P-Shreyas543/BatteryPack_16S_A4_Breakout/board_top_render.png

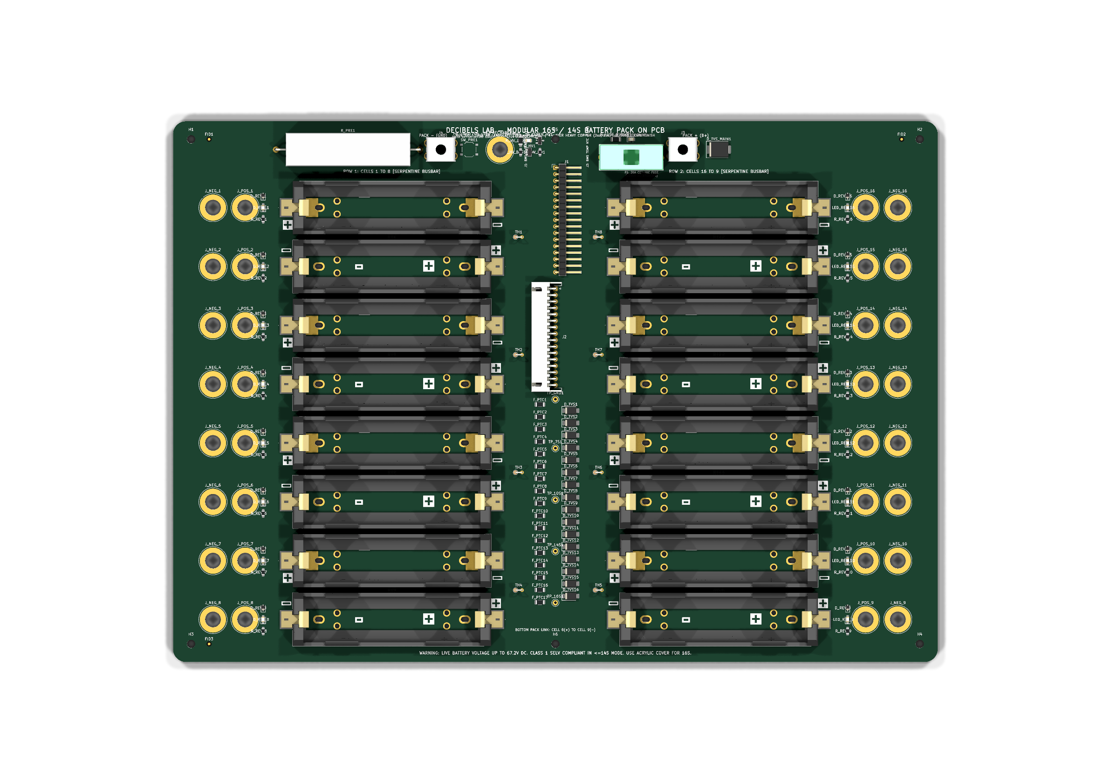
board_top_render.png
