P-Shreyas543/BatteryPack_16S_A4_Breakout/step_scatter.png

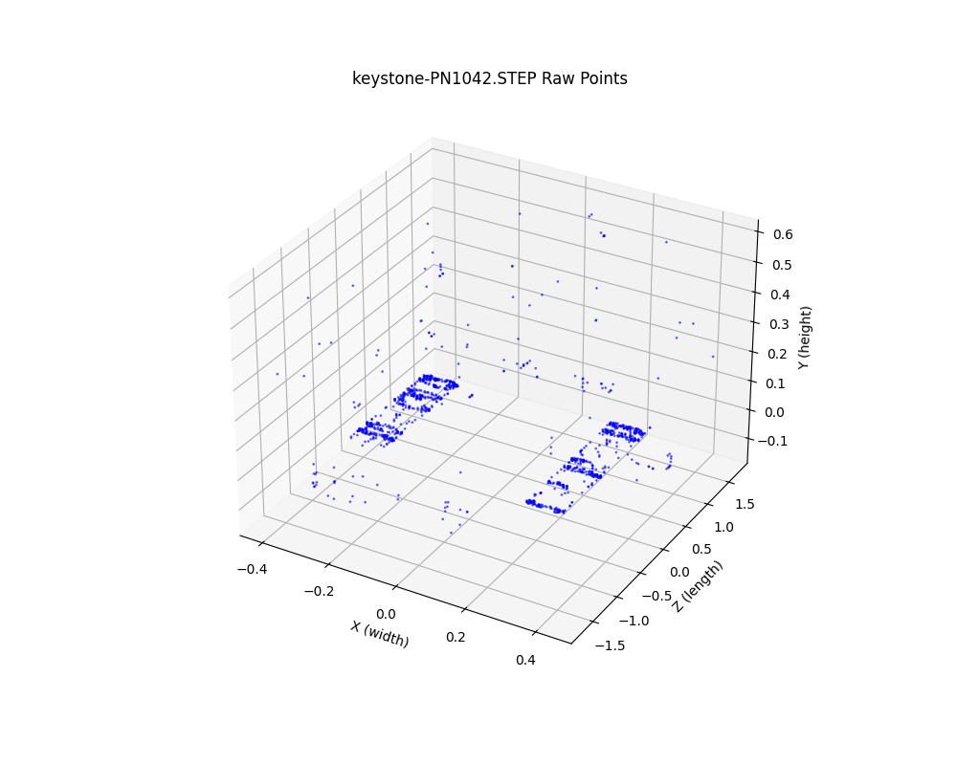
step_scatter.png
