P-Shreyas543/BatteryPack_16S_A4_Breakout/test_all_keystone.png

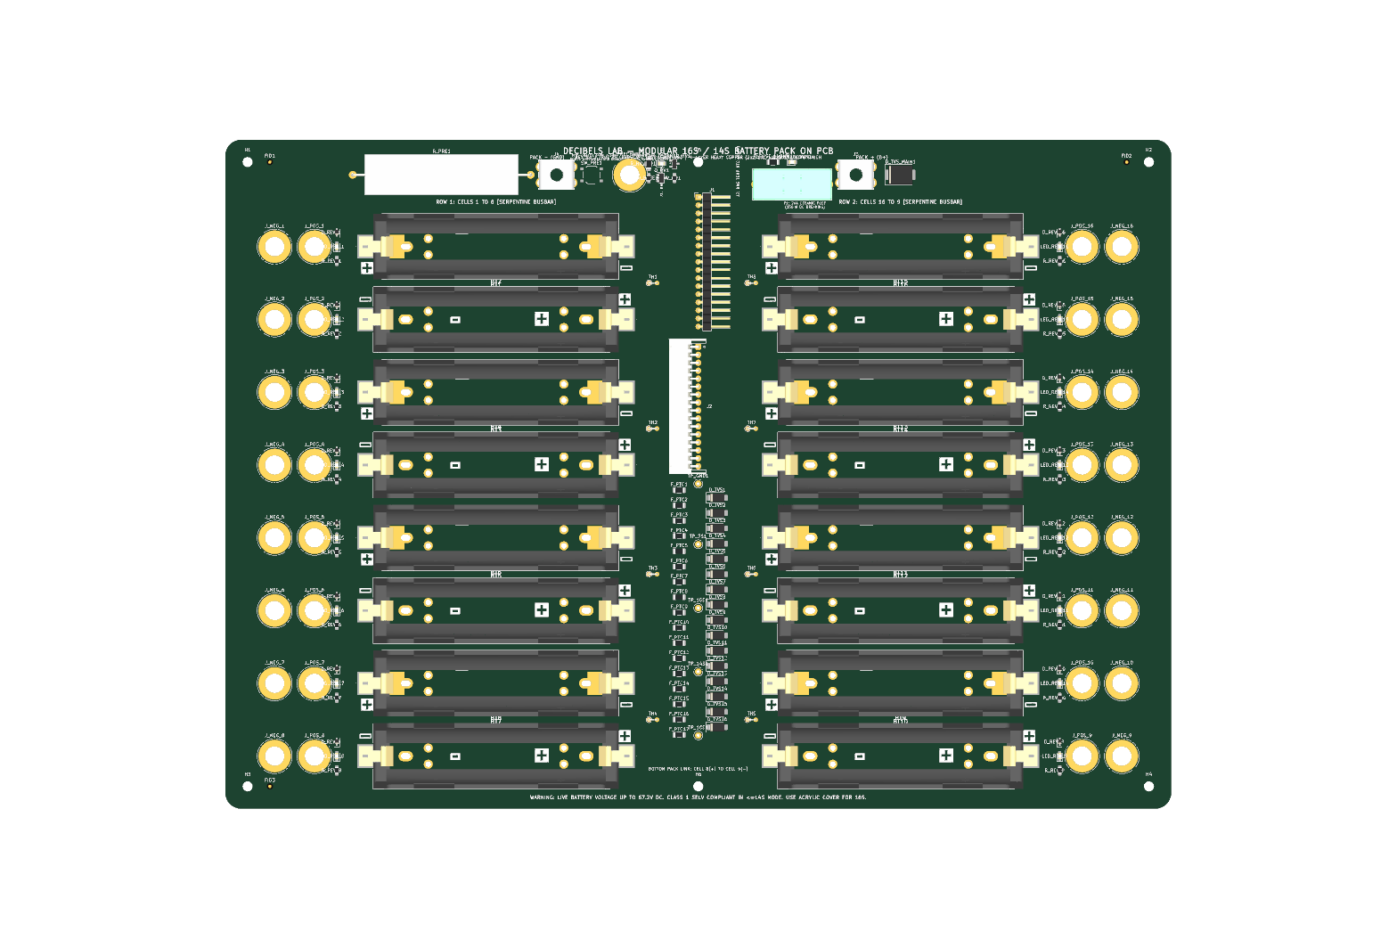
test_all_keystone.png
