P-Shreyas543/BatteryPack_16S_A4_Breakout/test_bt1_render_full.png

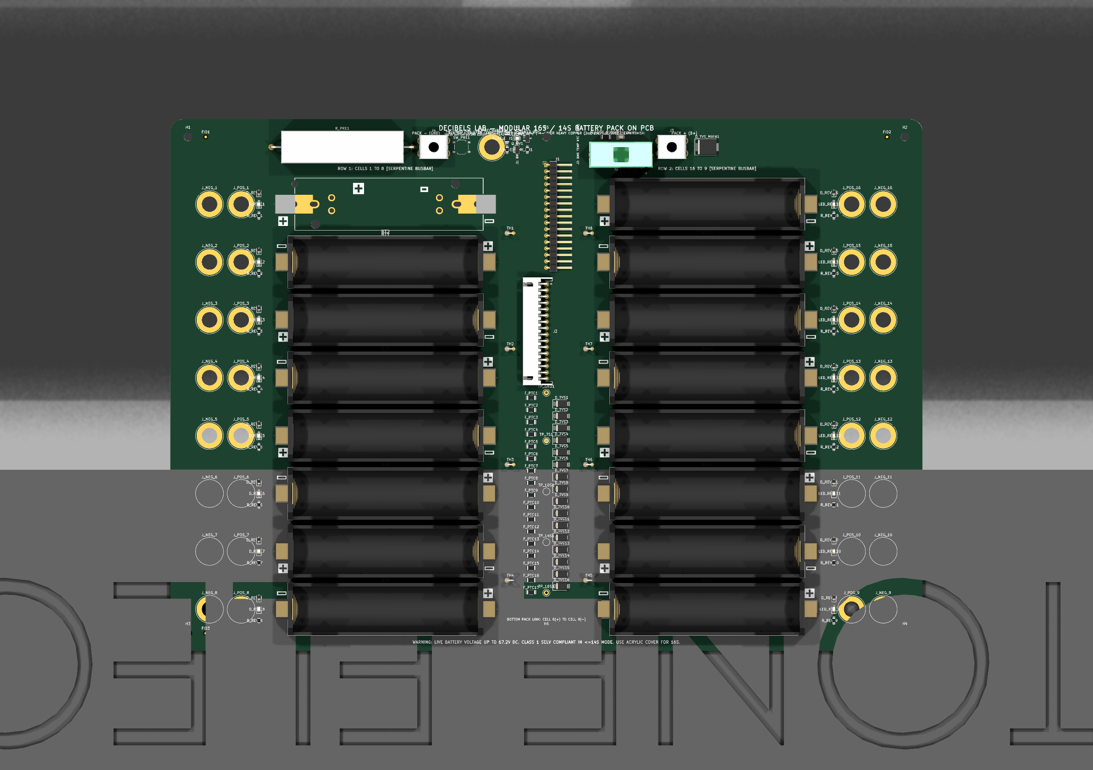
test_bt1_render_full.png
