P-Shreyas543/BatteryPack_16S_A4_Breakout/test_render_bt1.png

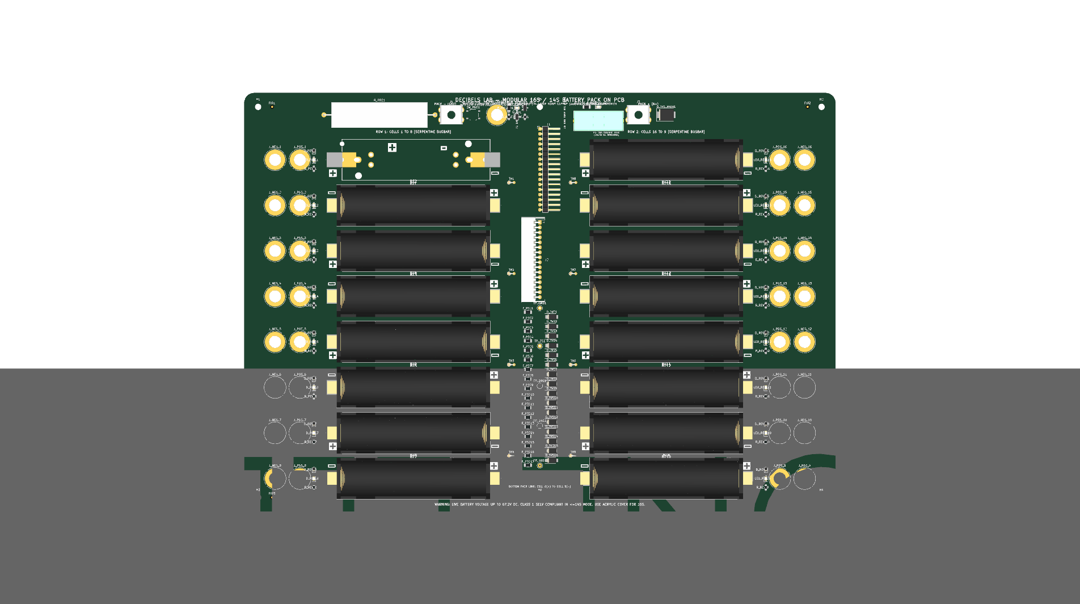
test_render_bt1.png
