P-Shreyas543/BatteryPack_16S_A4_Breakout/docs/BatteryPack_14S_Schematic.pdf

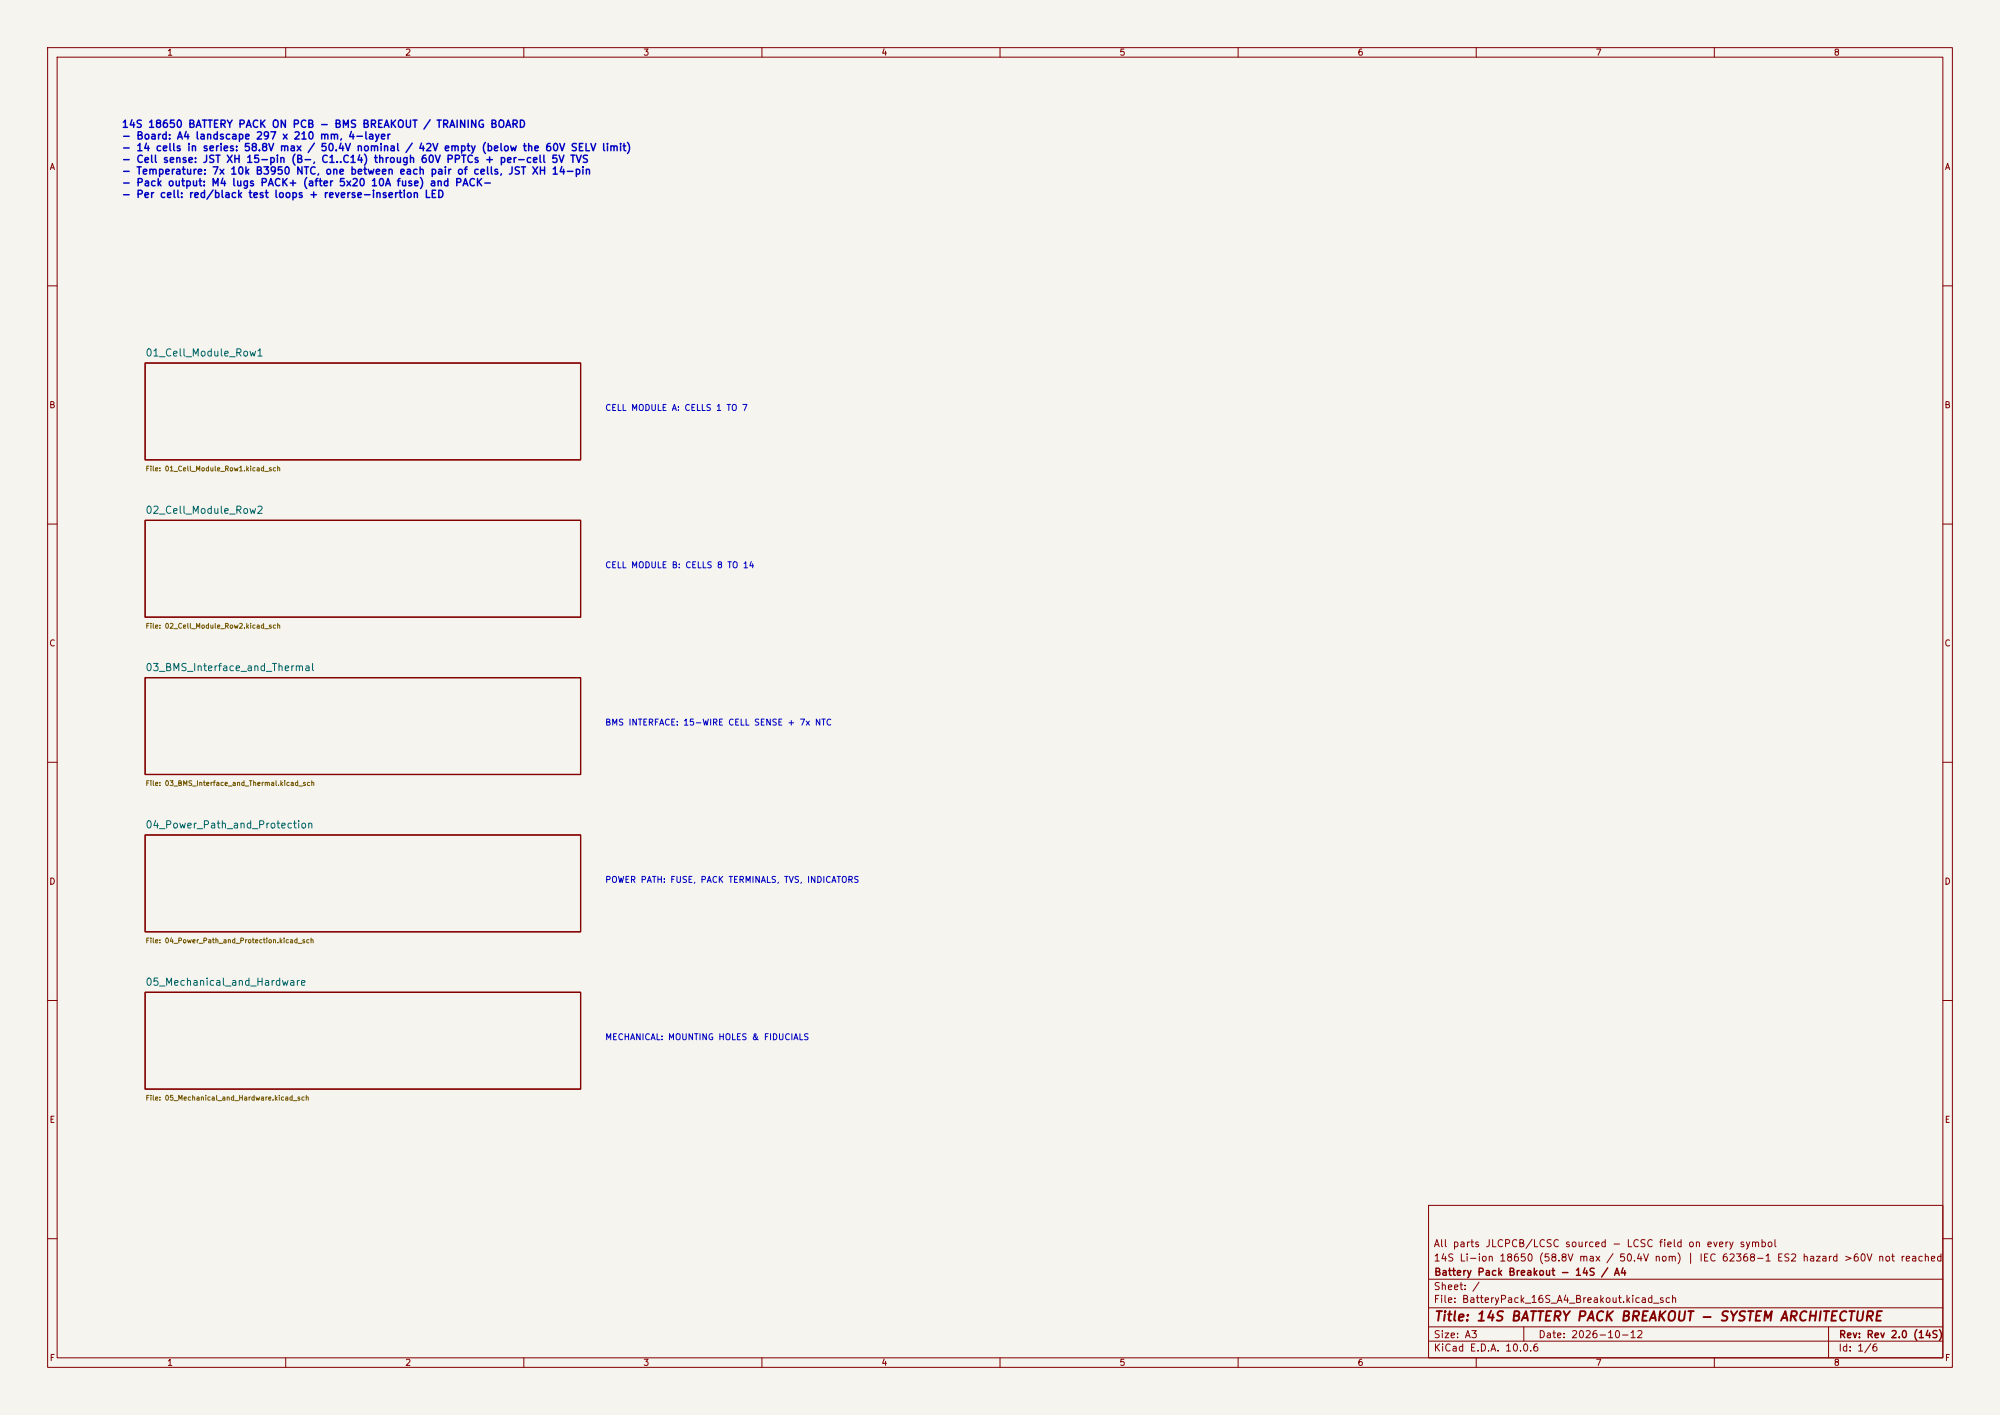
[picture p14: page 1]

14S 18650 BATTERY PACK ON PCB - BMS BREAKOUT / TRAINING BOARD - Board: A4 landscape 297 x 210 mm, 4-layer - 14 cells in series: 58.8V max / 50.4V nominal / 42V empty (below the 60V SELV limit) - Cell sense: JST XH 15-pin (B-, C1..C14) through 60V PPTCs + per-cell 5V TVS - Temperature: 7x 10k B3950 NTC, one between each pair of cells, JST XH 14-pin - Pack output: M4 lugs PACK+ (after 5x20 10A fuse) and PACK-

- Per cell: red/black test loops + reverse-insertion LED

CELL MODULE A: CELLS 1 TO 7 CELL MODULE B: CELLS 8 TO 14 BMS INTERFACE: 15-WIRE CELL SENSE + 7x NTC

POWER PATH: FUSE, PACK TERMINALS, TVS, INDICATORS MECHANICAL: MOUNTING HOLES & FIDUCIALS

All parts JLCPCB/LCSC sourced - LCSC field on every symbol
14S Li-ion 18650 (58.8V max / 50.4V nom) | IEC 62368-1 ES2 hazard >60V not reached
Battery Pack Breakout - 14S / A4
Sheet: /
File: BatteryPack_16S_A4_Breakout.kicad_sch
Title: 14S BATTERY PACK BREAKOUT - SYSTEM ARCHITECTURE

Size: A3 | Rev: Rev 2.0 (14S) | F Date: 2026-10-12
KiCad E.D.A. 10.0.6 | Id: 1/6

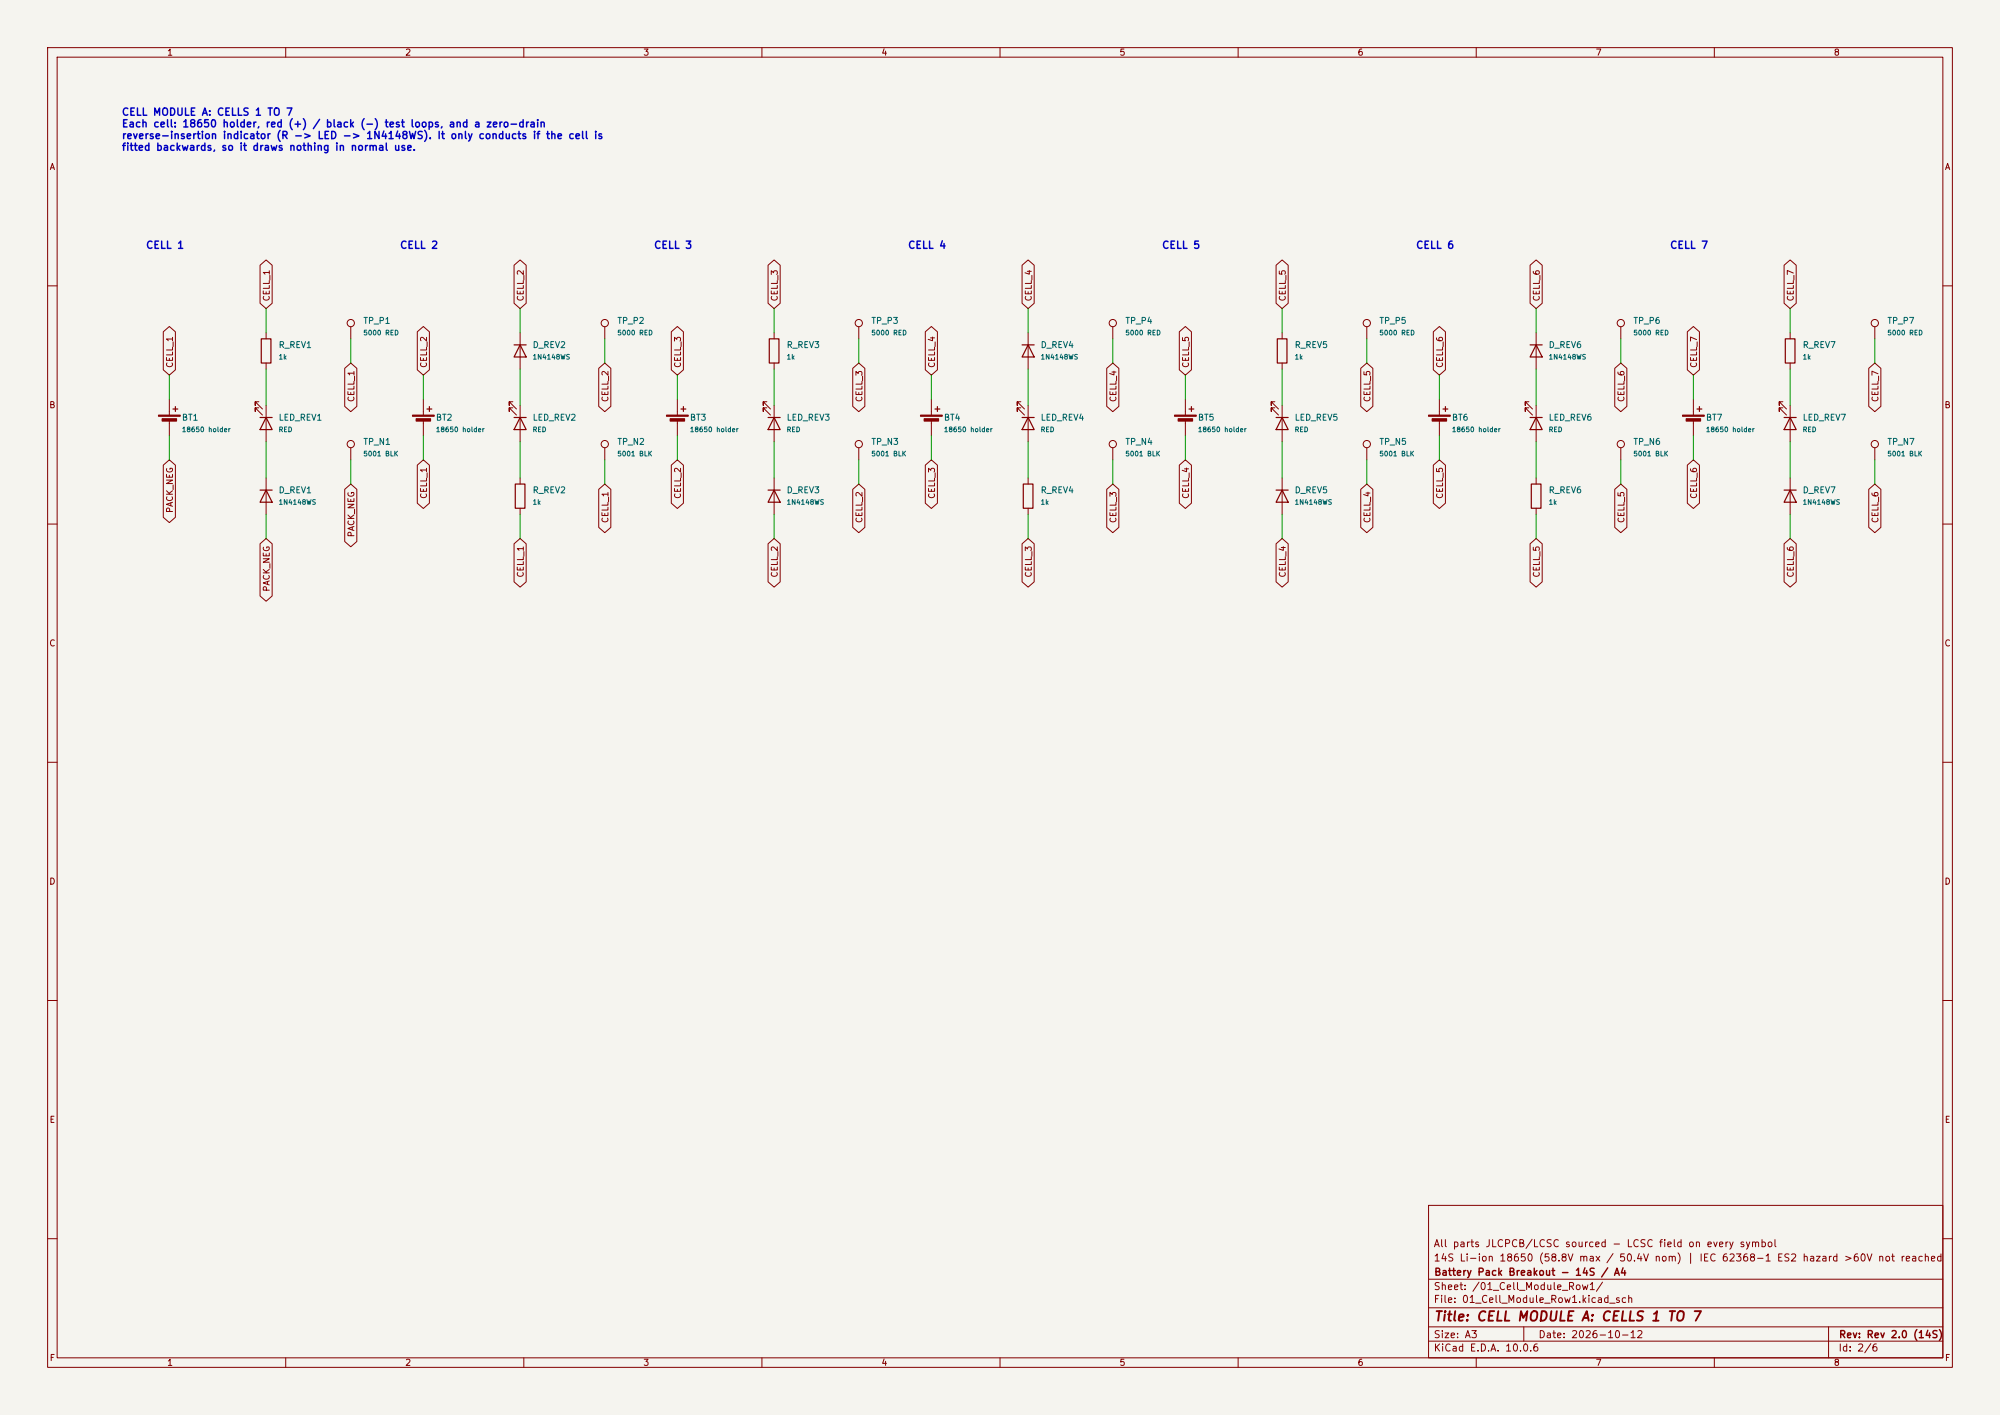
[picture p15: page 2]

CELL MODULE A: CELLS 1 TO 7
Each cell: 18650 holder, red (+) / black (-) test loops, and a zero-drain
reverse-insertion indicator (R -> LED -> 1N4148WS). It only conducts if the cell is

All parts JLCPCB/LCSC sourced - LCSC field on every symbol
14S Li-ion 18650 (58.8V max / 50.4V nom) | IEC 62368-1 ES2 hazard >60V not reached
Battery Pack Breakout - 14S / A4
Sheet: /01_Cell_Module_Row1/
File: 01_Cell_Module_Row1.kicad_sch
Title: CELL MODULE A: CELLS 1 TO 7

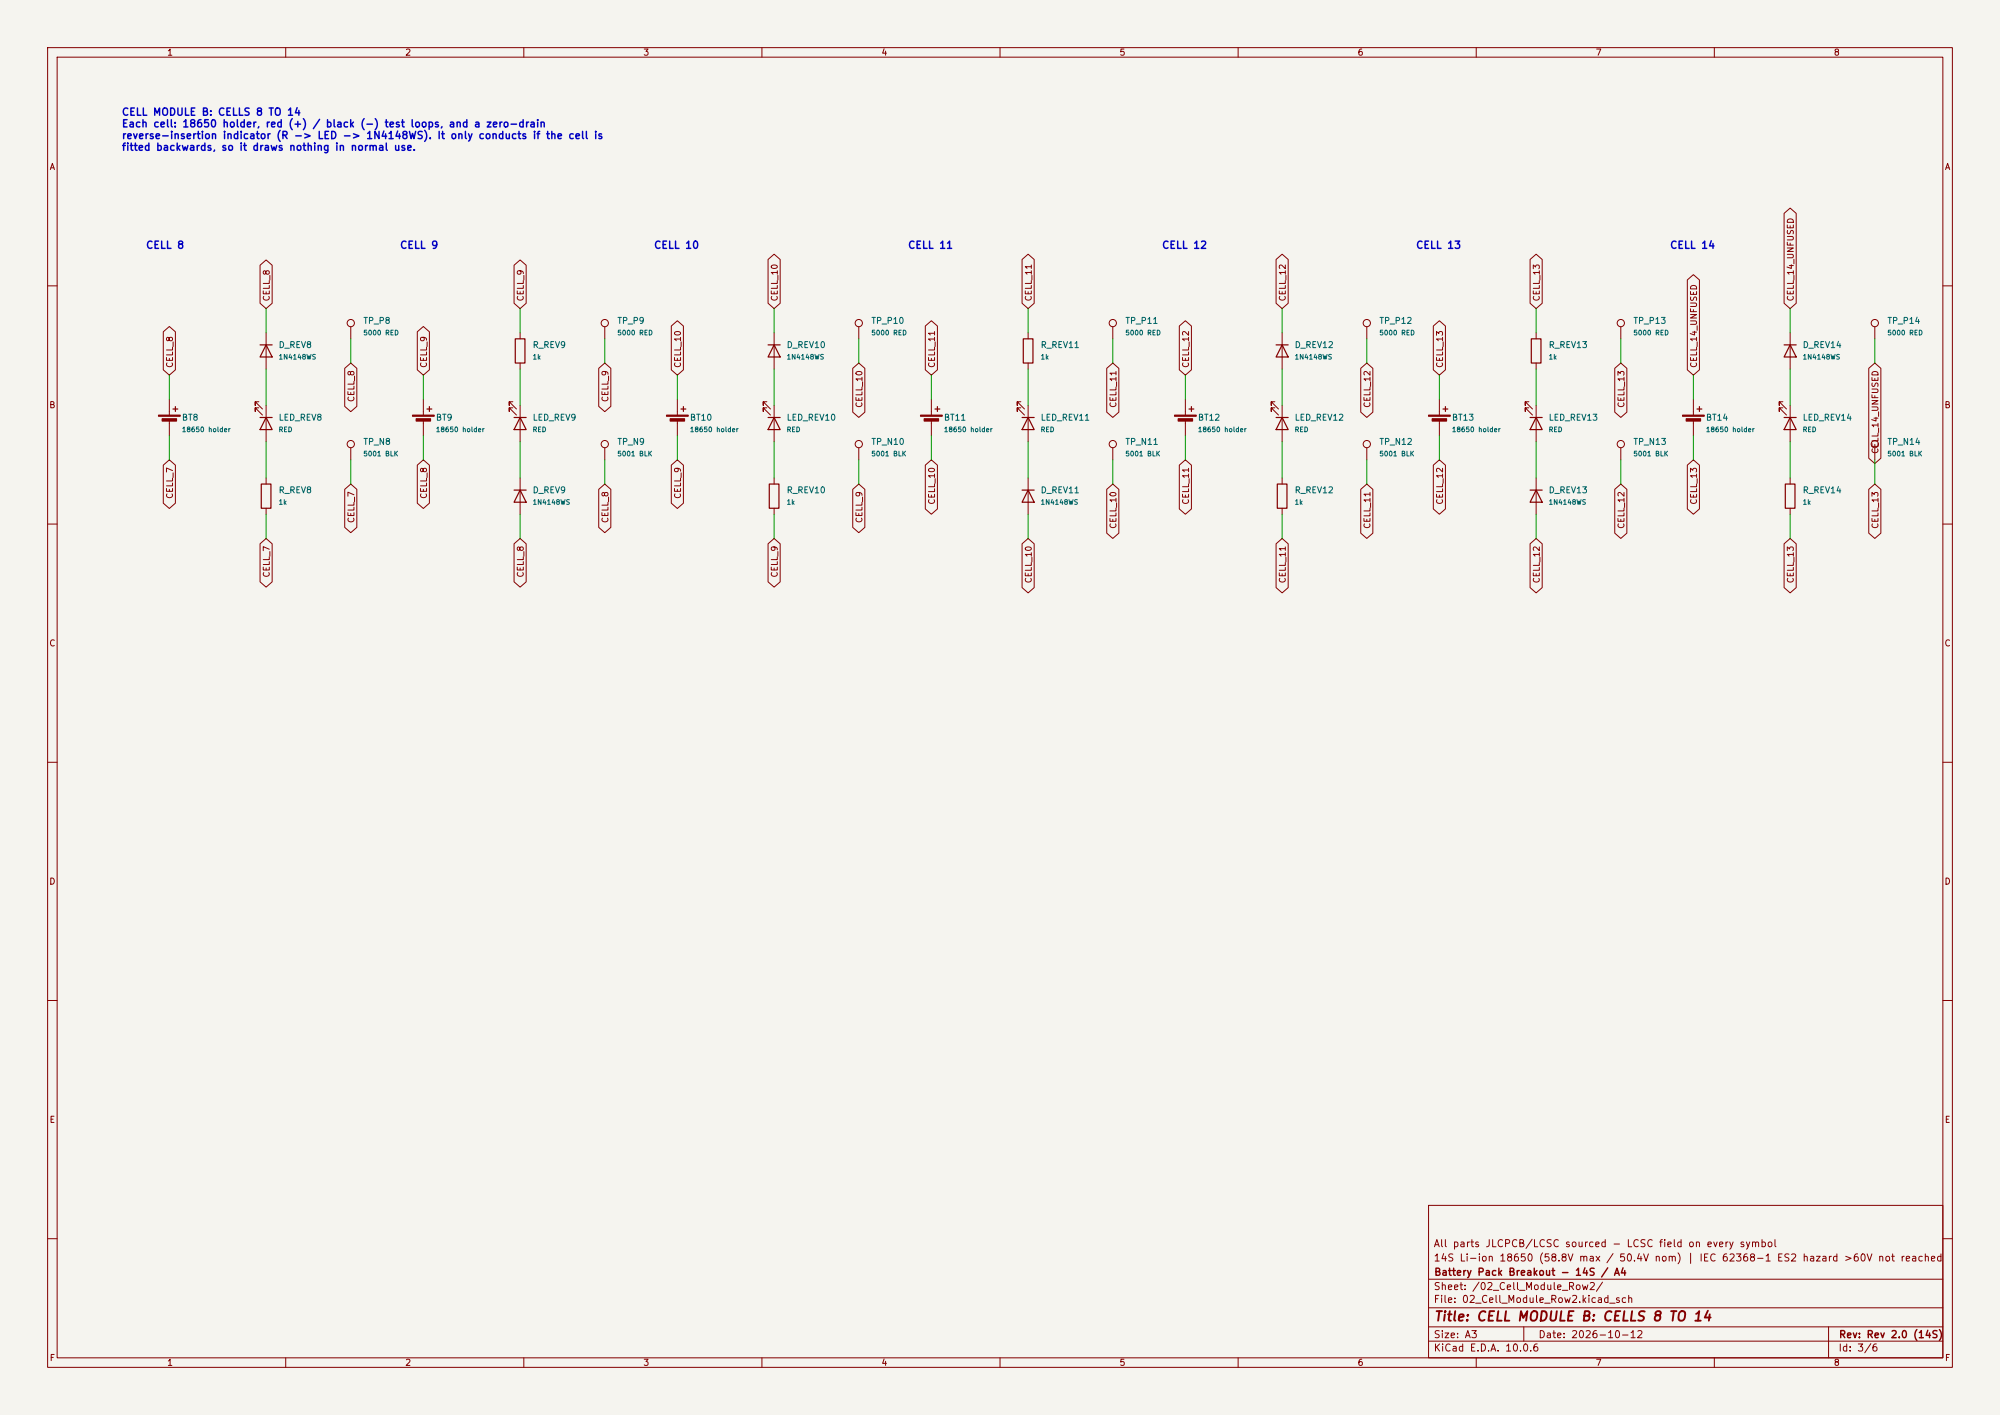
[picture p16: page 3]

CELL MODULE B: CELLS 8 TO 14
Each cell: 18650 holder, red (+) / black (-) test loops, and a zero-drain
reverse-insertion indicator (R -> LED -> 1N4148WS). It only conducts if the cell is
fitted backwards, so it draws nothing in normal use.

All parts JLCPCB/LCSC sourced - LCSC field on every symbol
14S Li-ion 18650 (58.8V max / 50.4V nom) | IEC 62368-1 ES2 hazard >60V not reached
Battery Pack Breakout - 14S / A4
Sheet: /02_Cell_Module_Row2/
File: 02_Cell_Module_Row2.kicad_sch
Title: CELL MODULE B: CELLS 8 TO 14

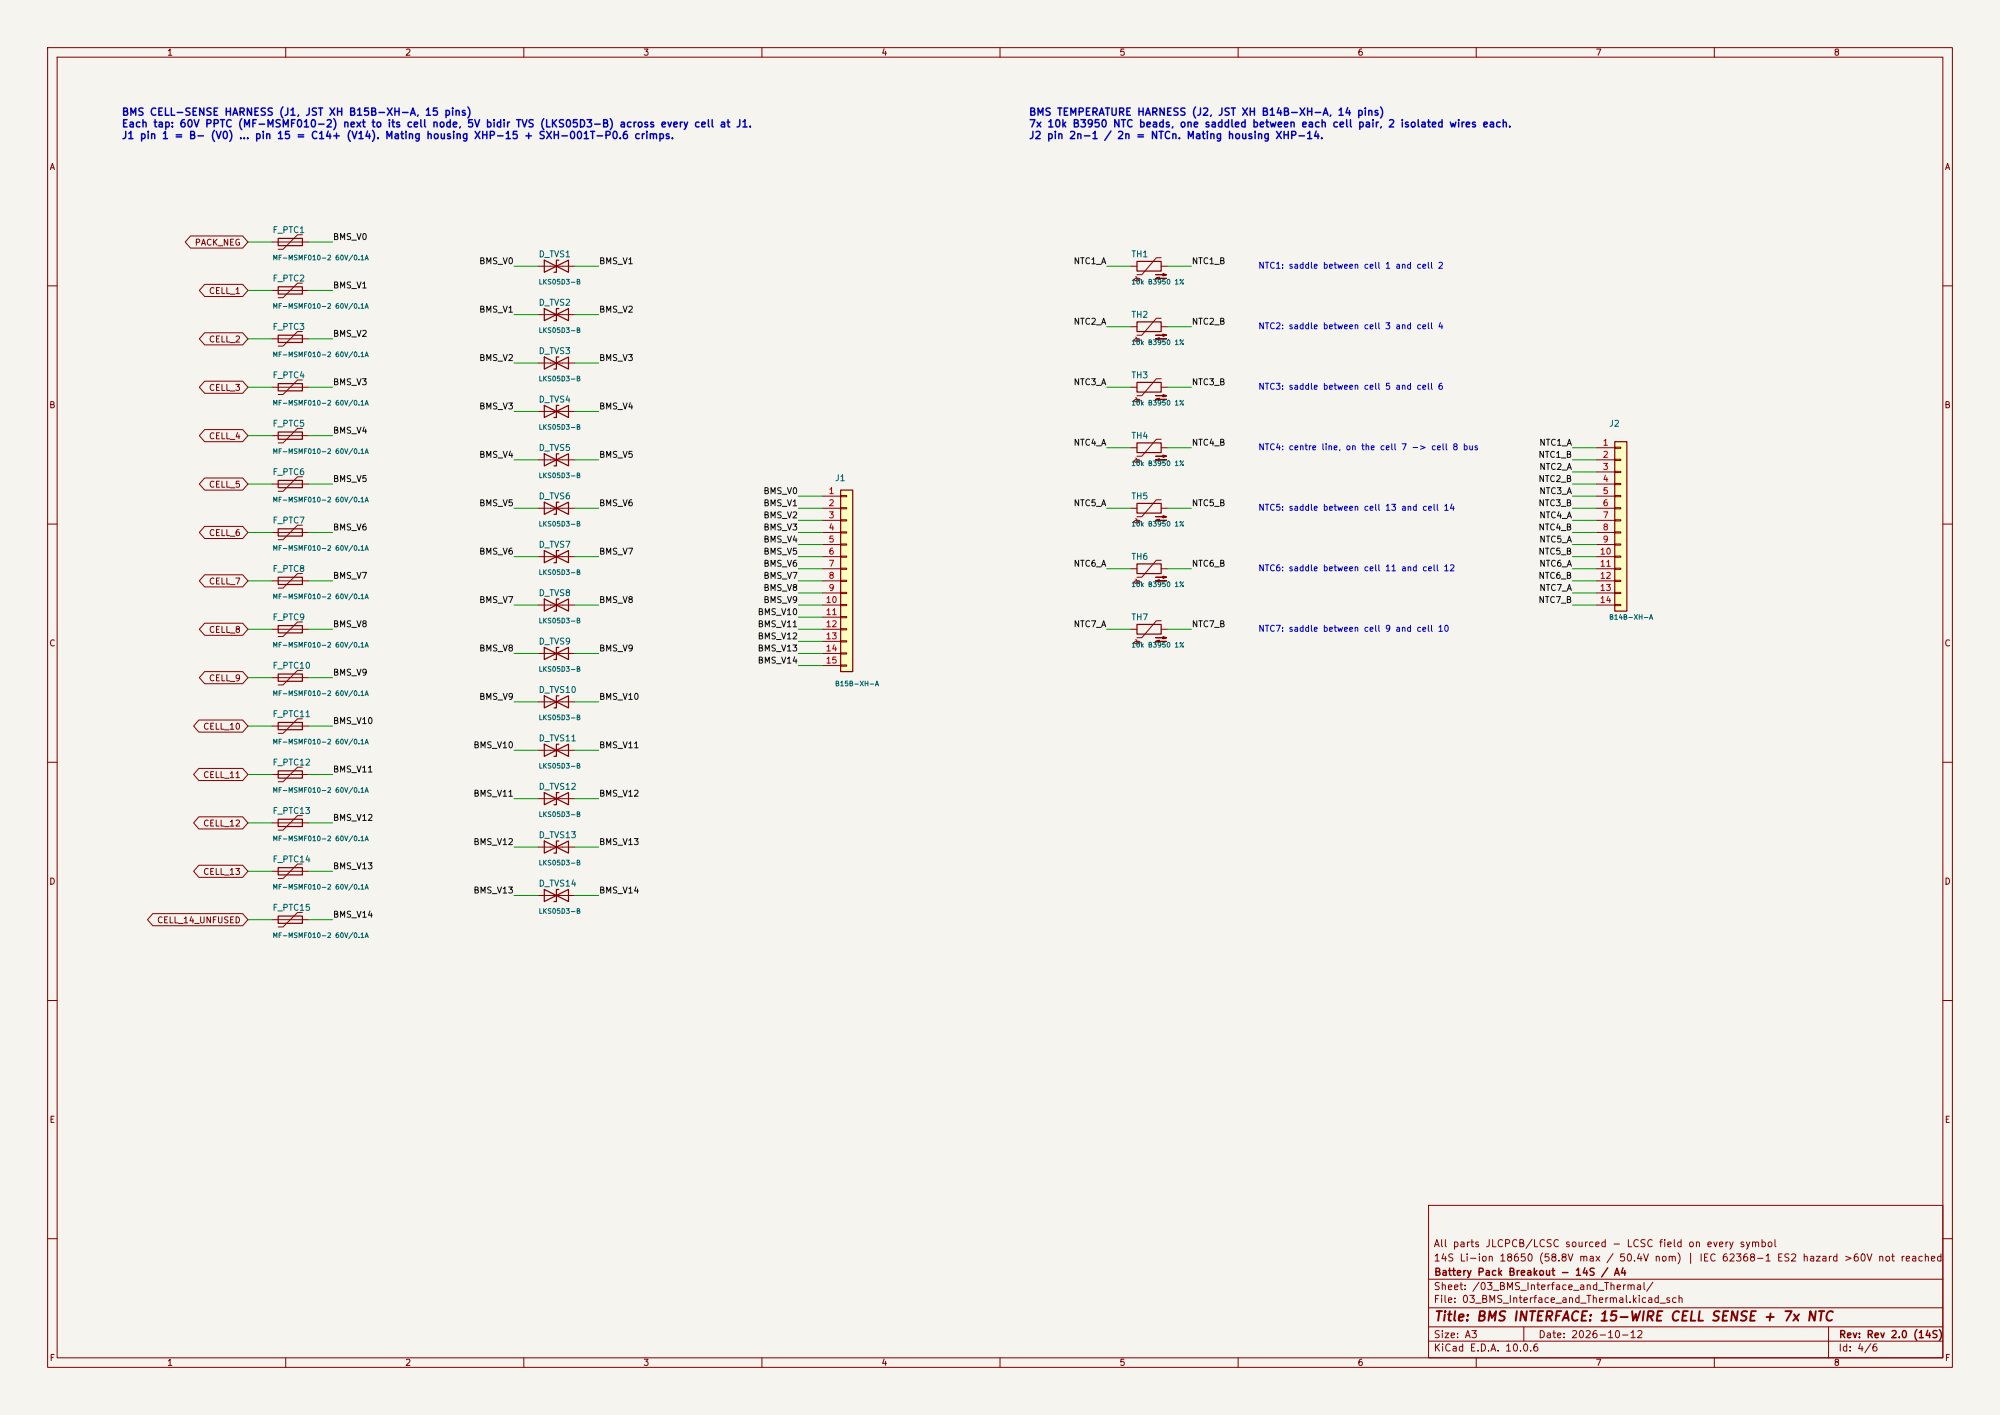
[picture p17: page 4]

J2 pin 2n-1 / 2n = NTCn. Mating housing XHP-14. NTC7: saddle between cell 9 and cell 10 NTC6: saddle between cell 11 and cell 12 BMS CELL-SENSE HARNESS (J1, JST XH B15B-XH-A, 15 pins)
Each tap: 60V PPTC (MF-MSMF010-2) next to its cell node, 5V bidir TVS (LKS05D3-B) across every cell at J1.
CELL_1 CELL_14_UNFUSED

7x 10k B3950 NTC beads, one saddled between each cell pair, 2 isolated wires each.

All parts JLCPCB/LCSC sourced - LCSC field on every symbol
14S Li-ion 18650 (58.8V max / 50.4V nom) | IEC 62368-1 ES2 hazard >60V not reached
Battery Pack Breakout - 14S / A4
Sheet: /03_BMS_Interface_and_Thermal/
File: 03_BMS_Interface_and_Thermal.kicad_sch
Title: BMS INTERFACE: 15-WIRE CELL SENSE + 7x NTC

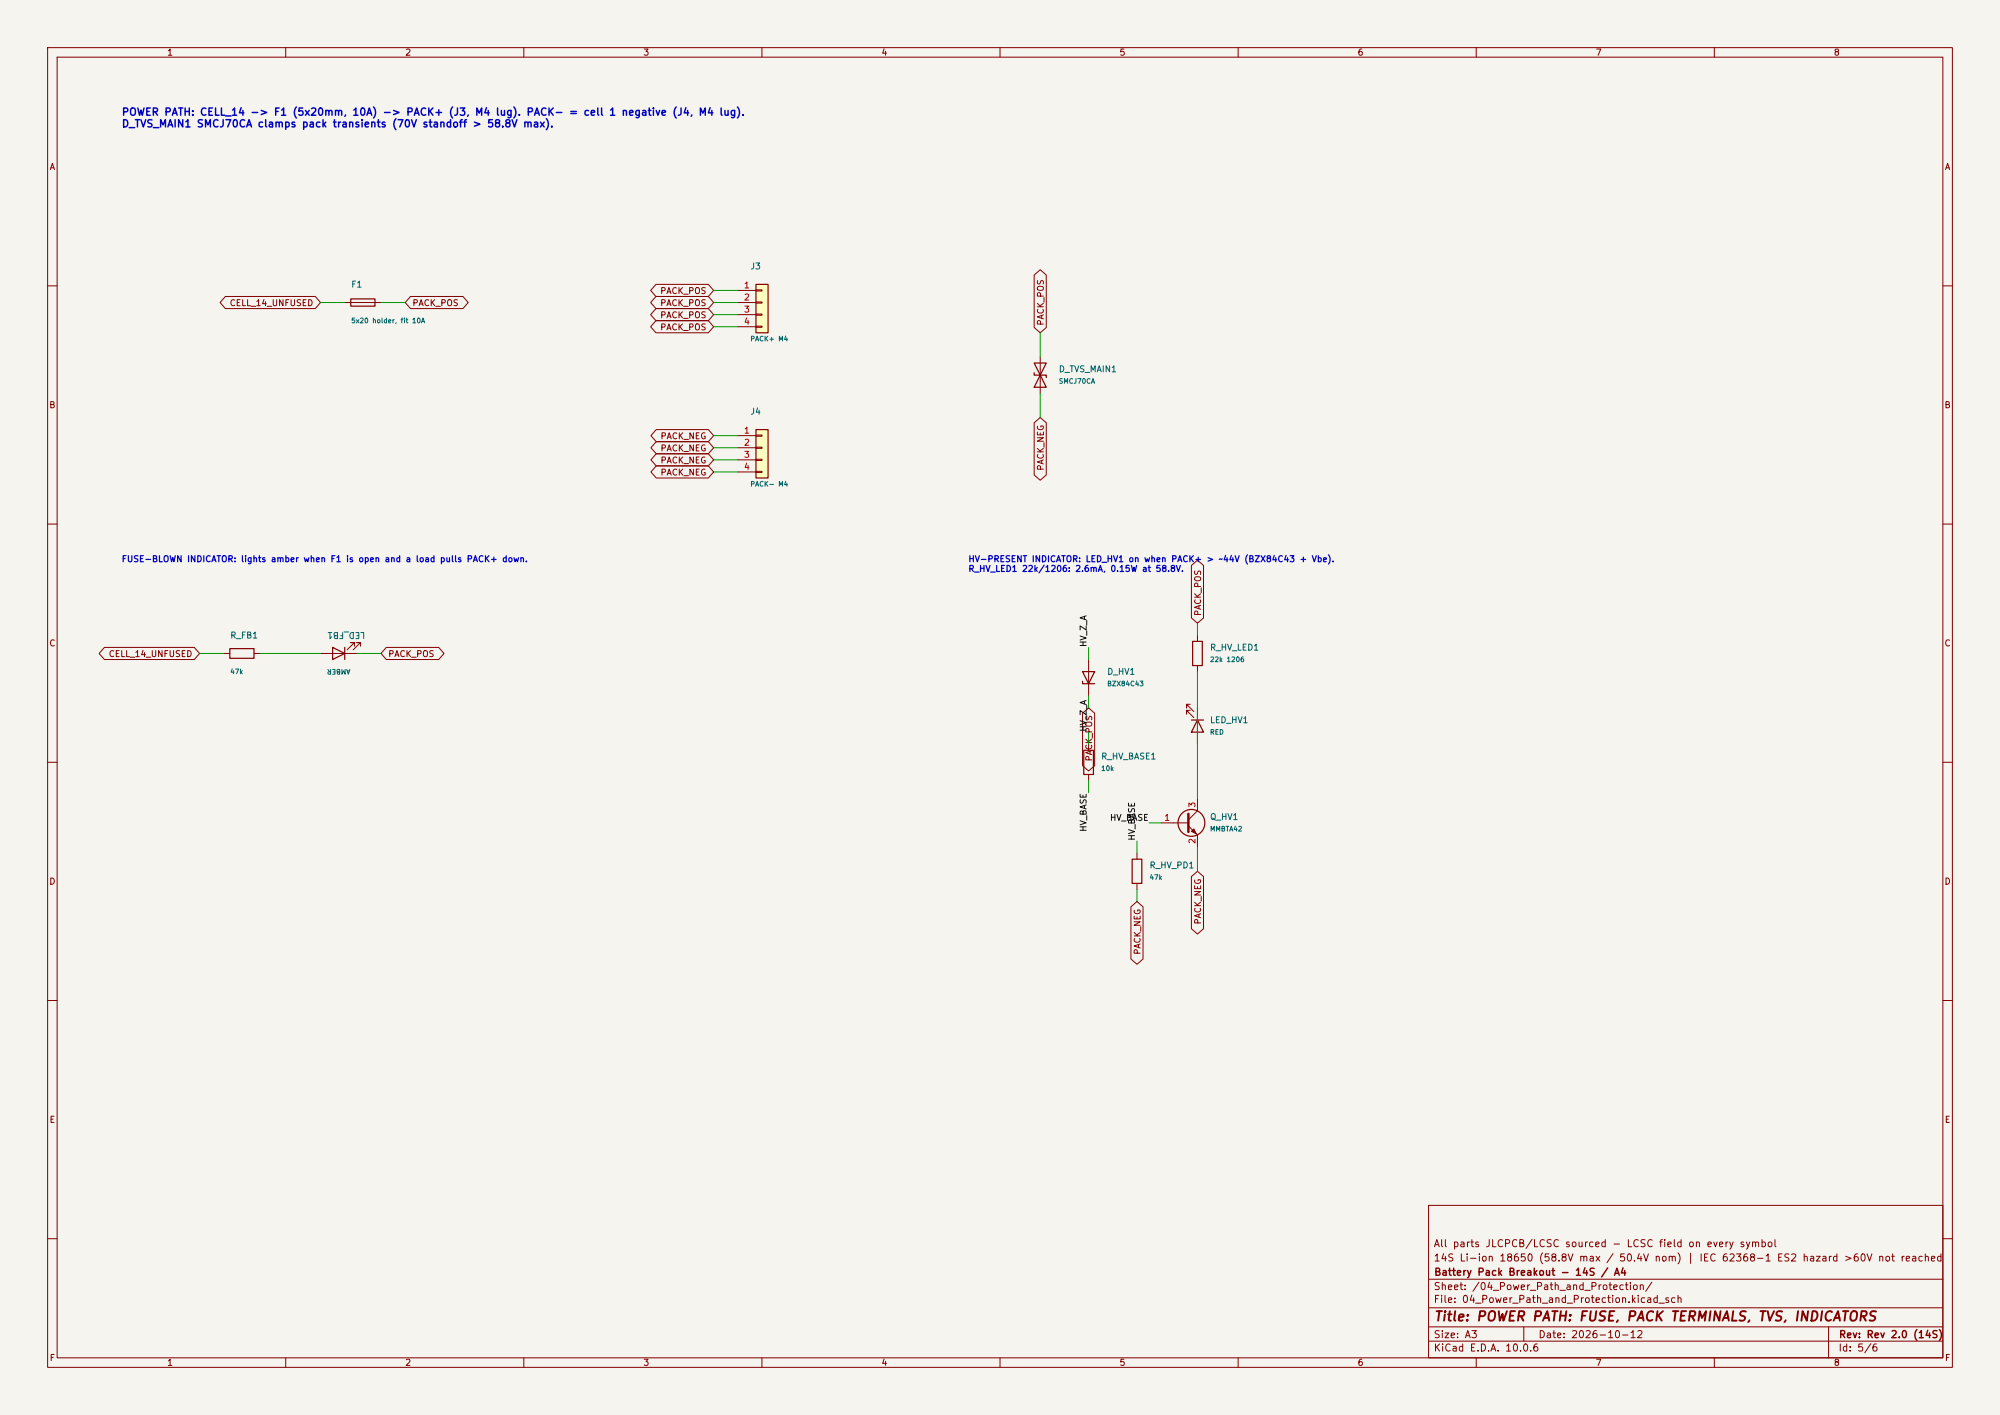
[picture p18: page 5]

POWER PATH: CELL_14 -> F1 (5x20mm, 10A) -> PACK+ (J3, M4 lug). PACK- = cell 1 negative (J4, M4 lug).

R_HV_LED1 22k/1206: 2.6mA, 0.15W at 58.8V. FUSE-BLOWN INDICATOR: lights amber when F1 is open and a load pulls PACK+ down.

All parts JLCPCB/LCSC sourced - LCSC field on every symbol
14S Li-ion 18650 (58.8V max / 50.4V nom) | IEC 62368-1 ES2 hazard >60V not reached
Battery Pack Breakout - 14S / A4
Sheet: /04_Power_Path_and_Protection/
File: 04_Power_Path_and_Protection.kicad_sch
Title: POWER PATH: FUSE, PACK TERMINALS, TVS, INDICATORS

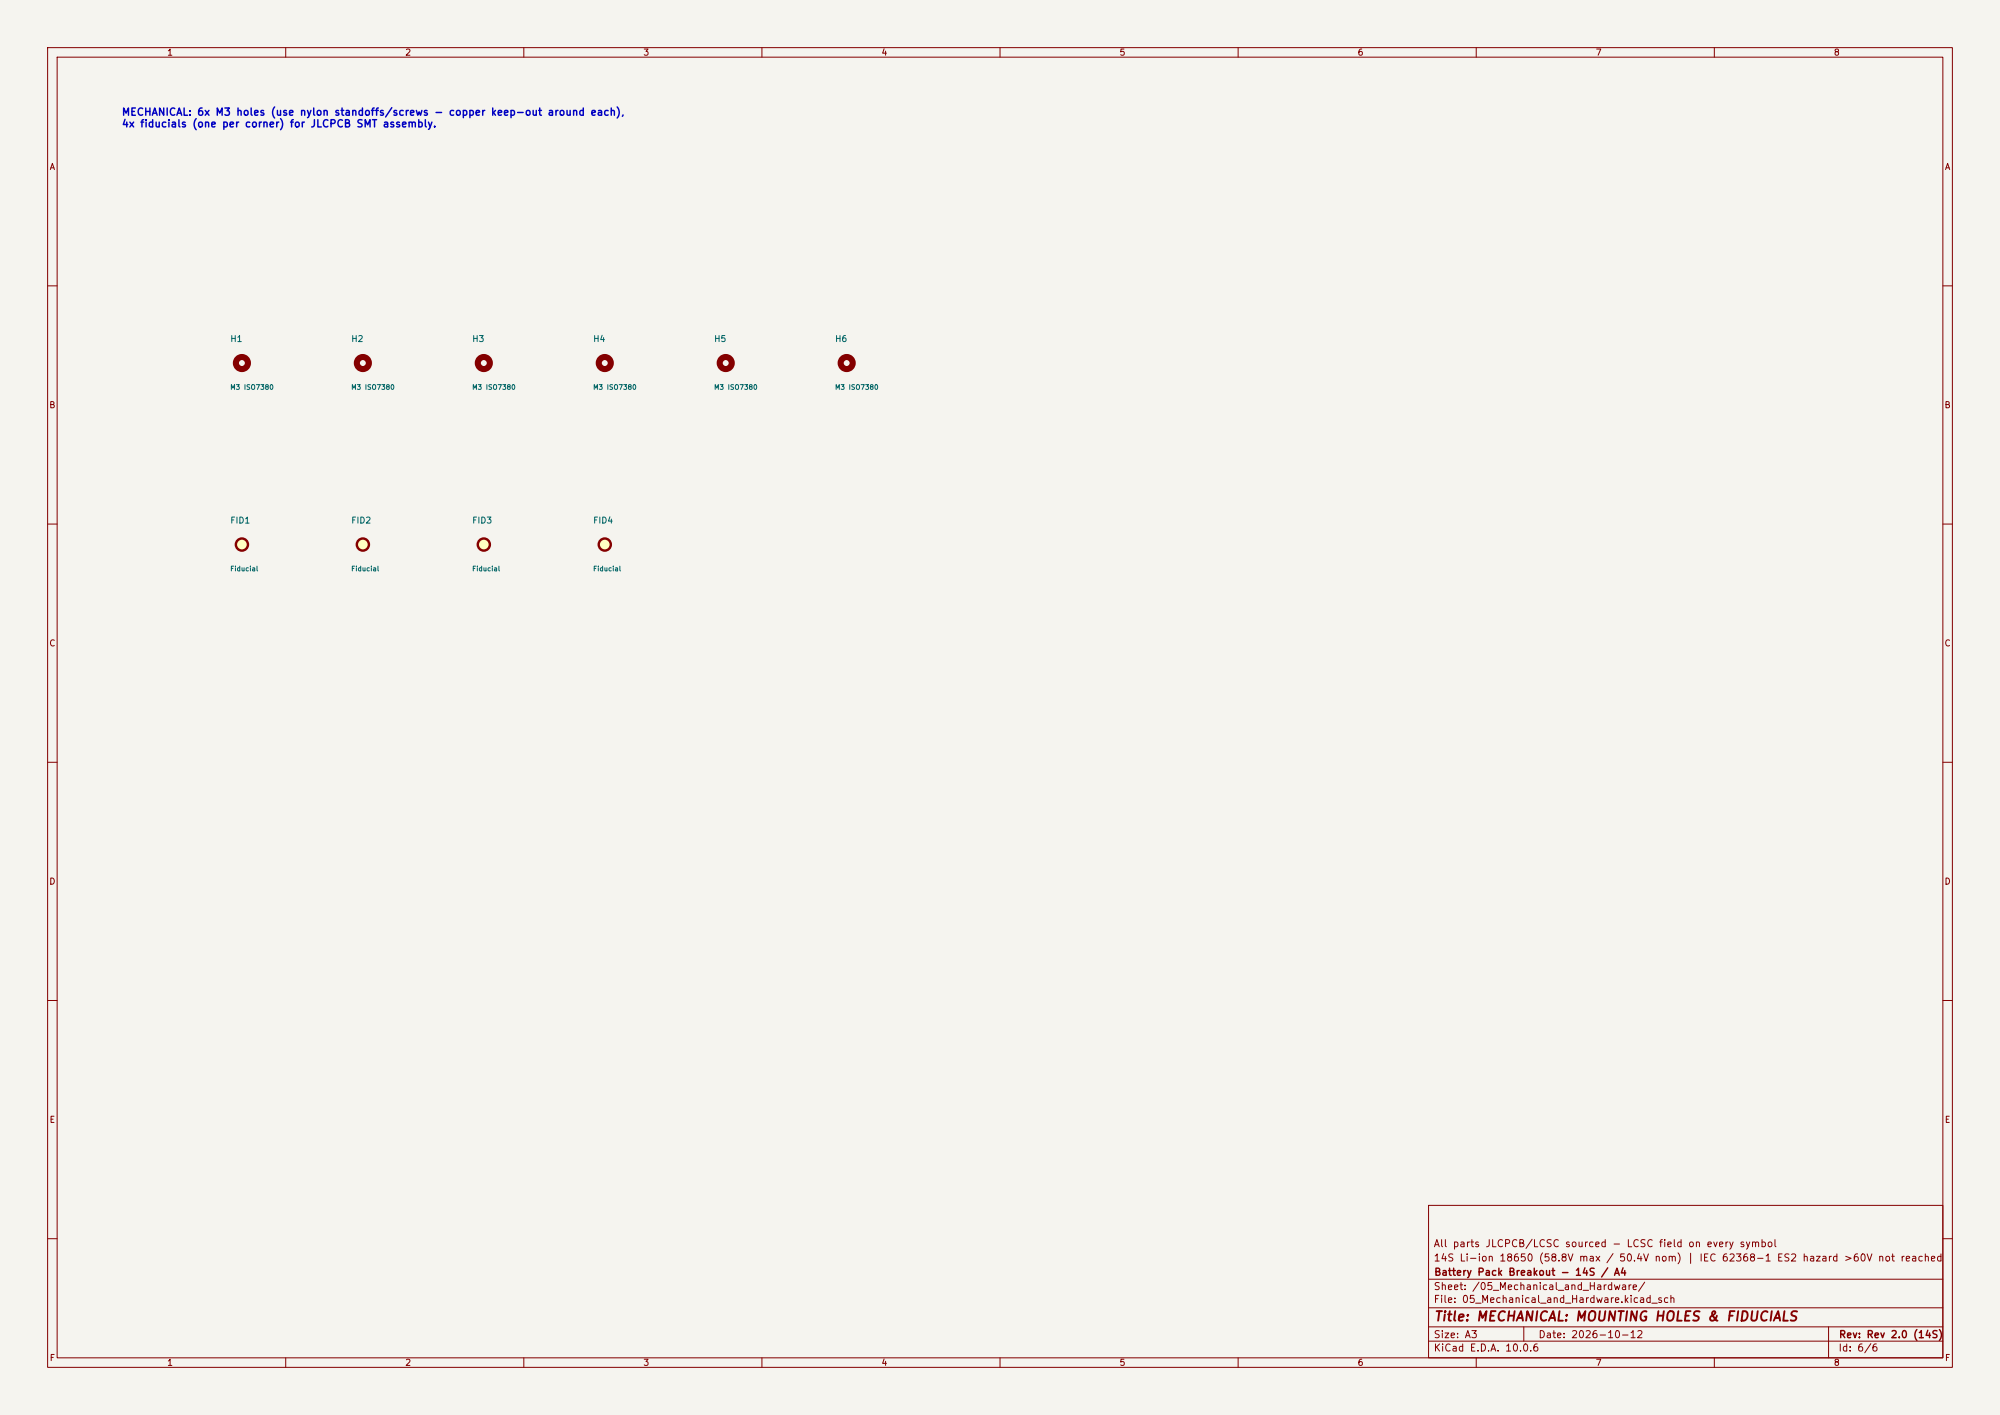
[picture p19: page 6]

M3 ISO7380 MECHANICAL: 6x M3 holes (use nylon standoffs/screws - copper keep-out around each), 4x fiducials (one per corner) for JLCPCB SMT assembly.

All parts JLCPCB/LCSC sourced - LCSC field on every symbol
14S Li-ion 18650 (58.8V max / 50.4V nom) | IEC 62368-1 ES2 hazard >60V not reached
Battery Pack Breakout - 14S / A4
Sheet: /05_Mechanical_and_Hardware/
File: 05_Mechanical_and_Hardware.kicad_sch
Title: MECHANICAL: MOUNTING HOLES & FIDUCIALS
