P-Shreyas543/BatteryPack_16S_A4_Breakout/(list of files, drawings)

Other design files:
tools/sch_ids.json
