P-Shreyas543/BatteryPack_16S_A4_Breakout/BatteryPack_16S_A4_Breakout.kicad_pcb

## KiCad design BatteryPack_16S_A4_Breakout.kicad_pcb (2026-10-16)

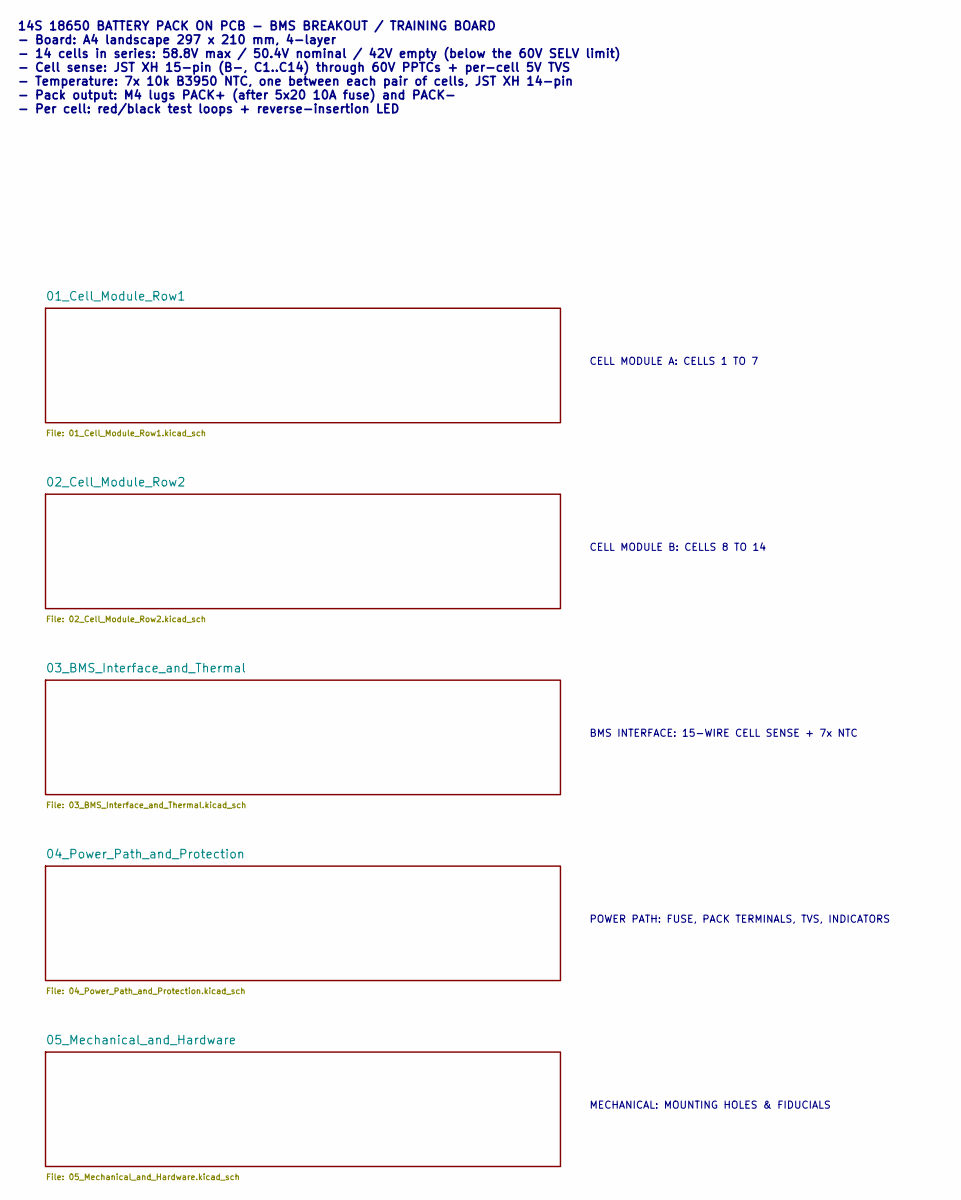
[picture p20: schematic BatteryPack_16S_A4_Breakout.kicad_sch, 14S BATTERY PACK BREAKOUT - SYSTEM ARCHITECTURE]

Notes on the sheet:
MECHANICAL: MOUNTING HOLES & FIDUCIALS
CELL MODULE B: CELLS 8 TO 14
BMS INTERFACE: 15-WIRE CELL SENSE + 7x NTC
POWER PATH: FUSE, PACK TERMINALS, TVS, INDICATORS
14S 18650 BATTERY PACK ON PCB - BMS BREAKOUT / TRAINING BOARD - Board: A4 landscape 297 x 210 mm, 4-layer - 14 cells in series: 58.8V max / 50.4V nominal / 42V empty (below the 60V SELV limit) - Cell sense: JST XH 15-pin (B-, C1..C14) through 60V PPTCs + per-cell 5V TVS - Temperature: 7x 10k B3950 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
CELL MODULE A: CELLS 1 TO 7

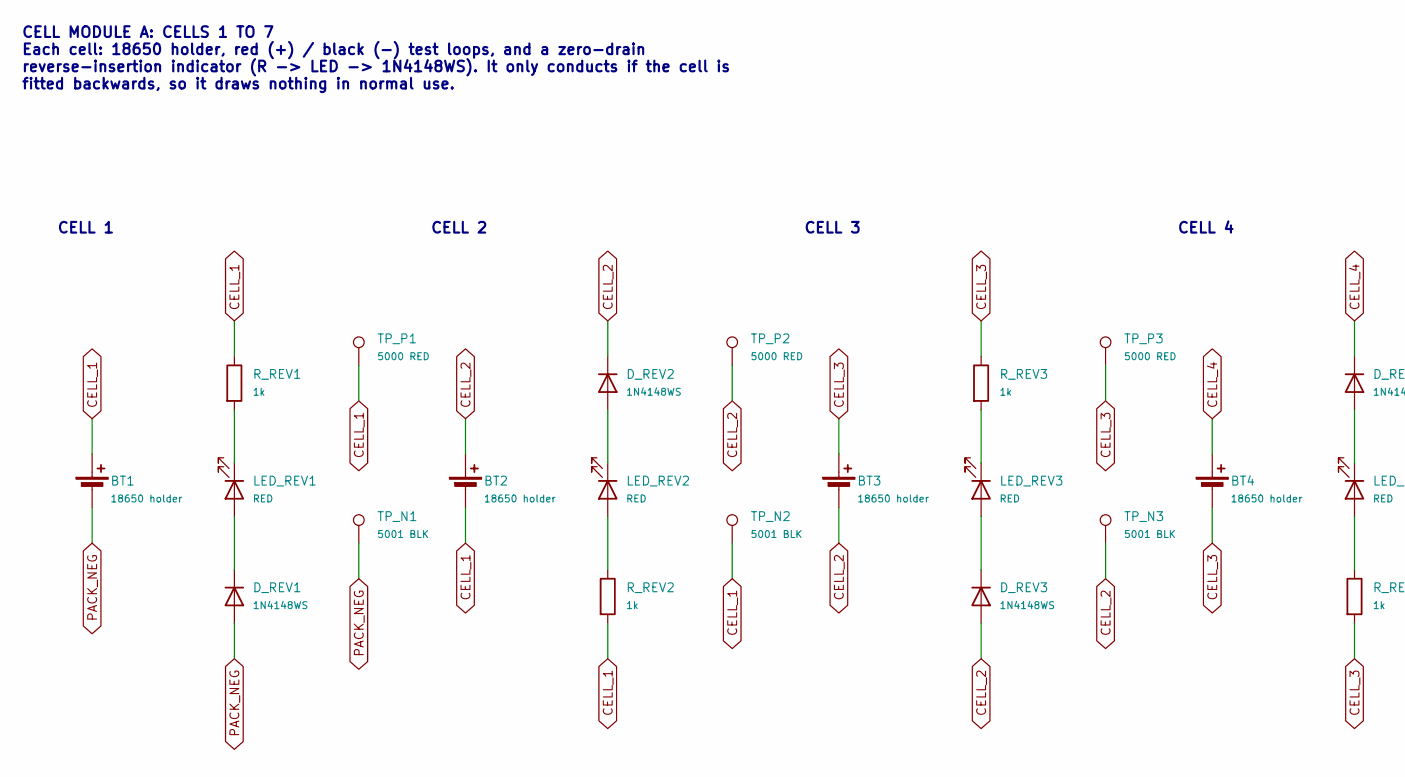
[picture p21: schematic 01_Cell_Module_Row1.kicad_sch, CELL MODULE A: CELLS 1 TO 7, part in row 1, column 1]

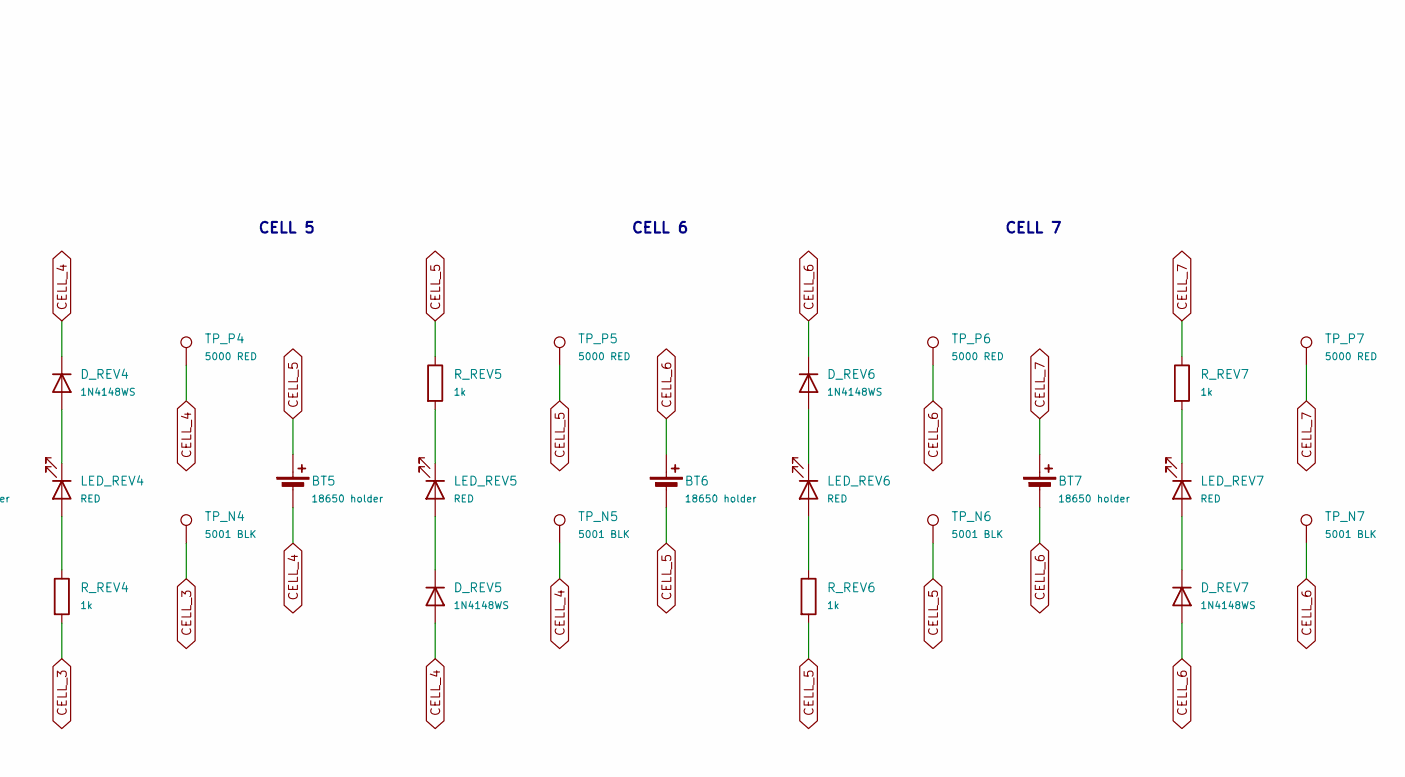
[picture p22: schematic 01_Cell_Module_Row1.kicad_sch, CELL MODULE A: CELLS 1 TO 7, part in row 1, column 2]

Parts:
BT1, BT2, BT3, BT4, BT5, BT6, BT7: 18650 holder; BH18650B1BA002; MPN BH-18650-B1BA002; LCSC C2988620
D_REV1, D_REV2, D_REV3, D_REV4, D_REV5, D_REV6, D_REV7: 1N4148WS; D_SOD-323; MPN 1N4148WS; LCSC C2128
LED_REV1, LED_REV2, LED_REV3, LED_REV4, LED_REV5, LED_REV6, LED_REV7: RED; LED_0805_2012Metric; MPN NCD0805R1; LCSC C84256
R_REV1, R_REV2, R_REV3, R_REV4, R_REV5, R_REV6, R_REV7: 1k; R_0805_2012Metric; MPN 0805W8F1001T5E; LCSC C17513
TP_N1, TP_N2, TP_N3, TP_N4, TP_N5, TP_N6, TP_N7: 5001 BLK; TestPoint_Keystone_5000-5004_Miniature; MPN 5001; LCSC C238122
TP_P1, TP_P2, TP_P3, TP_P4, TP_P5, TP_P6, TP_P7: 5000 RED; TestPoint_Keystone_5000-5004_Miniature; MPN 5000; LCSC C5199900

Connections:
CELL_1: BT1.1 (+), BT2.2 (-), R_REV1.1, R_REV2.2, TP_N2.1, TP_P1.1; also elsewhere on the board
CELL_2: BT2.1 (+), BT3.2 (-), D_REV2.1 (K), D_REV3.2 (A), TP_N3.1, TP_P2.1; also elsewhere on the board
CELL_3: BT3.1 (+), BT4.2 (-), R_REV3.1, R_REV4.2, TP_N4.1, TP_P3.1; also elsewhere on the board
CELL_4: BT4.1 (+), BT5.2 (-), D_REV4.1 (K), D_REV5.2 (A), TP_N5.1, TP_P4.1; also elsewhere on the board
CELL_5: BT5.1 (+), BT6.2 (-), R_REV5.1, R_REV6.2, TP_N6.1, TP_P5.1; also elsewhere on the board
CELL_6: BT6.1 (+), BT7.2 (-), D_REV6.1 (K), D_REV7.2 (A), TP_N7.1, TP_P6.1; also elsewhere on the board
CELL_7: BT7.1 (+), R_REV7.1, TP_P7.1; also elsewhere on the board
unnamed: D_REV1.1 (K), LED_REV1.2 (A)
unnamed: D_REV2.2 (A), LED_REV2.1 (K)
unnamed: D_REV3.1 (K), LED_REV3.2 (A)
unnamed: D_REV4.2 (A), LED_REV4.1 (K)
unnamed: D_REV5.1 (K), LED_REV5.2 (A)
unnamed: D_REV6.2 (A), LED_REV6.1 (K)
unnamed: D_REV7.1 (K), LED_REV7.2 (A)
unnamed: LED_REV1.1 (K), R_REV1.2
unnamed: LED_REV2.2 (A), R_REV2.1
unnamed: LED_REV3.1 (K), R_REV3.2
unnamed: LED_REV4.2 (A), R_REV4.1
unnamed: LED_REV5.1 (K), R_REV5.2
unnamed: LED_REV6.2 (A), R_REV6.1
unnamed: LED_REV7.1 (K), R_REV7.2
PACK_NEG: BT1.2 (-), D_REV1.2 (A), TP_N1.1; also elsewhere on the board

Notes on the sheet:
CELL 4
CELL 2
CELL 7
CELL 3
CELL 5
CELL 6
CELL 1
CELL MODULE A: CELLS 1 TO 7 Each cell: 18650 holder, red (+) / black (-) test loops, and a zero-drain reverse-insertion indicator (R -> LED -> 1N4148WS). It only conducts if the cell is fitted backwards, so it draws nothing in normal use.

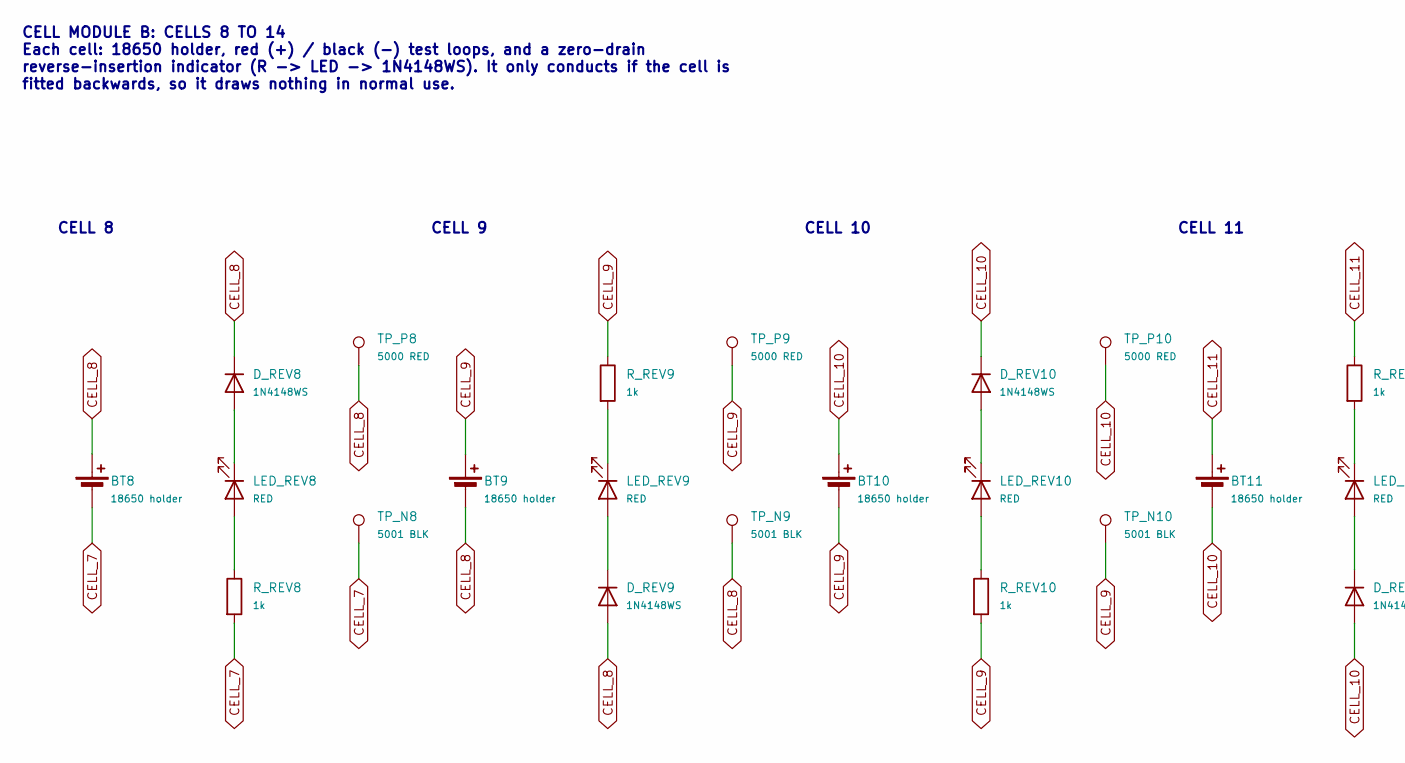
[picture p23: schematic 02_Cell_Module_Row2.kicad_sch, CELL MODULE B: CELLS 8 TO 14, part in row 1, column 1]

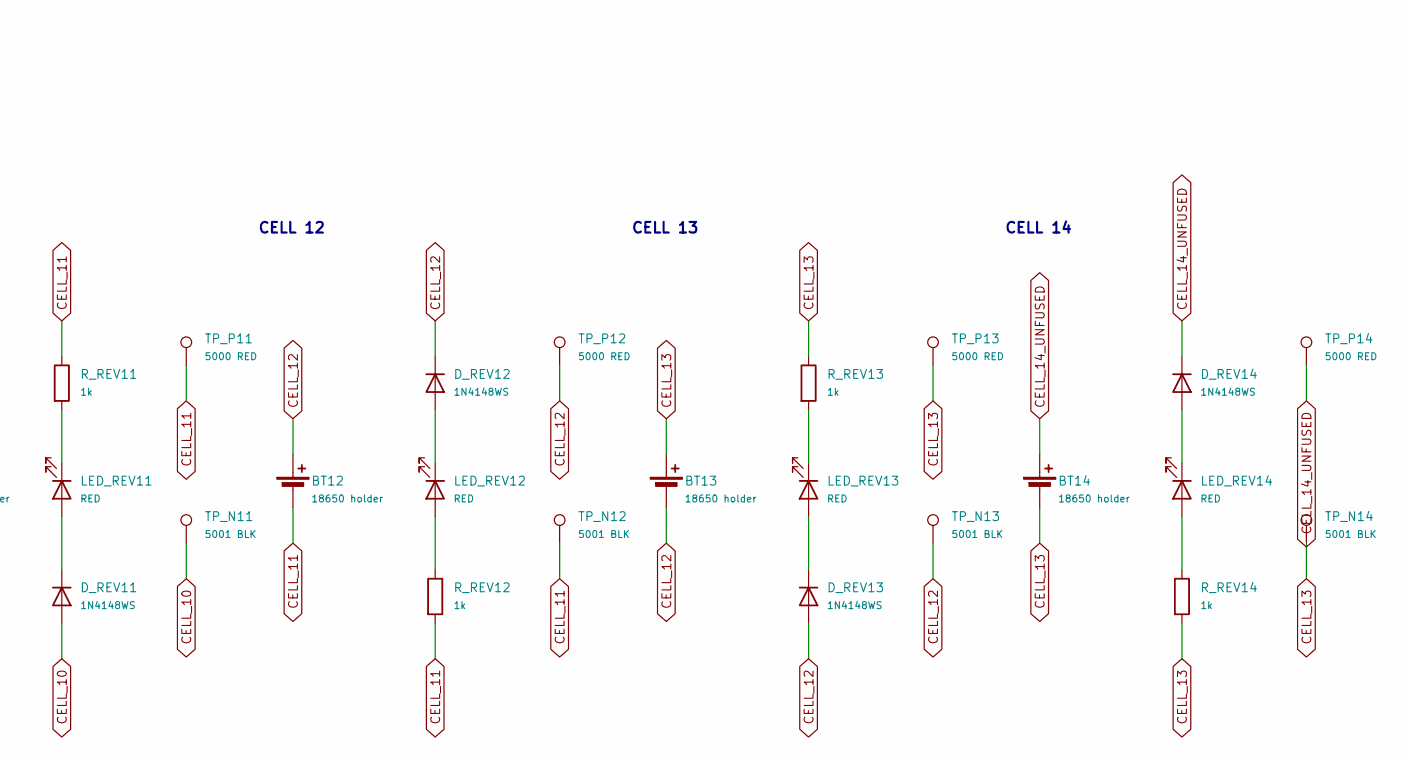
[picture p24: schematic 02_Cell_Module_Row2.kicad_sch, CELL MODULE B: CELLS 8 TO 14, part in row 1, column 2]

Parts:
BT8, BT9, BT10, BT11, BT12, BT13, BT14: 18650 holder; BH18650B1BA002; MPN BH-18650-B1BA002; LCSC C2988620
D_REV8, D_REV9, D_REV10, D_REV11, D_REV12, D_REV13, D_REV14: 1N4148WS; D_SOD-323; MPN 1N4148WS; LCSC C2128
LED_REV8, LED_REV9, LED_REV10, LED_REV11, LED_REV12, LED_REV13, LED_REV14: RED; LED_0805_2012Metric; MPN NCD0805R1; LCSC C84256
R_REV8, R_REV9, R_REV10, R_REV11, R_REV12, R_REV13, R_REV14: 1k; R_0805_2012Metric; MPN 0805W8F1001T5E; LCSC C17513
TP_N8, TP_N9, TP_N10, TP_N11, TP_N12, TP_N13, TP_N14: 5001 BLK; TestPoint_Keystone_5000-5004_Miniature; MPN 5001; LCSC C238122
TP_P8, TP_P9, TP_P10, TP_P11, TP_P12, TP_P13, TP_P14: 5000 RED; TestPoint_Keystone_5000-5004_Miniature; MPN 5000; LCSC C5199900

Connections:
CELL_7: BT8.2 (-), R_REV8.2, TP_N8.1; also elsewhere on the board
CELL_8: BT8.1 (+), BT9.2 (-), D_REV8.1 (K), D_REV9.2 (A), TP_N9.1, TP_P8.1; also elsewhere on the board
CELL_9: BT9.1 (+), BT10.2 (-), R_REV9.1, R_REV10.2, TP_N10.1, TP_P9.1; also elsewhere on the board
CELL_10: BT10.1 (+), BT11.2 (-), D_REV10.1 (K), D_REV11.2 (A), TP_N11.1, TP_P10.1; also elsewhere on the board
CELL_11: BT11.1 (+), BT12.2 (-), R_REV11.1, R_REV12.2, TP_N12.1, TP_P11.1; also elsewhere on the board
CELL_12: BT12.1 (+), BT13.2 (-), D_REV12.1 (K), D_REV13.2 (A), TP_N13.1, TP_P12.1; also elsewhere on the board
CELL_13: BT13.1 (+), BT14.2 (-), R_REV13.1, R_REV14.2, TP_N14.1, TP_P13.1; also elsewhere on the board
CELL_14_UNFUSED: BT14.1 (+), D_REV14.1 (K), TP_P14.1; also elsewhere on the board
unnamed: D_REV8.2 (A), LED_REV8.1 (K)
unnamed: D_REV9.1 (K), LED_REV9.2 (A)
unnamed: D_REV10.2 (A), LED_REV10.1 (K)
unnamed: D_REV11.1 (K), LED_REV11.2 (A)
unnamed: D_REV12.2 (A), LED_REV12.1 (K)
unnamed: D_REV13.1 (K), LED_REV13.2 (A)
unnamed: D_REV14.2 (A), LED_REV14.1 (K)
unnamed: LED_REV8.2 (A), R_REV8.1
unnamed: LED_REV9.1 (K), R_REV9.2
unnamed: LED_REV10.2 (A), R_REV10.1
unnamed: LED_REV11.1 (K), R_REV11.2
unnamed: LED_REV12.2 (A), R_REV12.1
unnamed: LED_REV13.1 (K), R_REV13.2
unnamed: LED_REV14.2 (A), R_REV14.1

Notes on the sheet:
CELL 13
CELL MODULE B: CELLS 8 TO 14 Each cell: 18650 holder, red (+) / black (-) test loops, and a zero-drain reverse-insertion indicator (R -> LED -> 1N4148WS). It only conducts if the cell is fitted backwards, so it draws nothing in normal use.
CELL 9
CELL 14
CELL 12
CELL 8
CELL 10
CELL 11

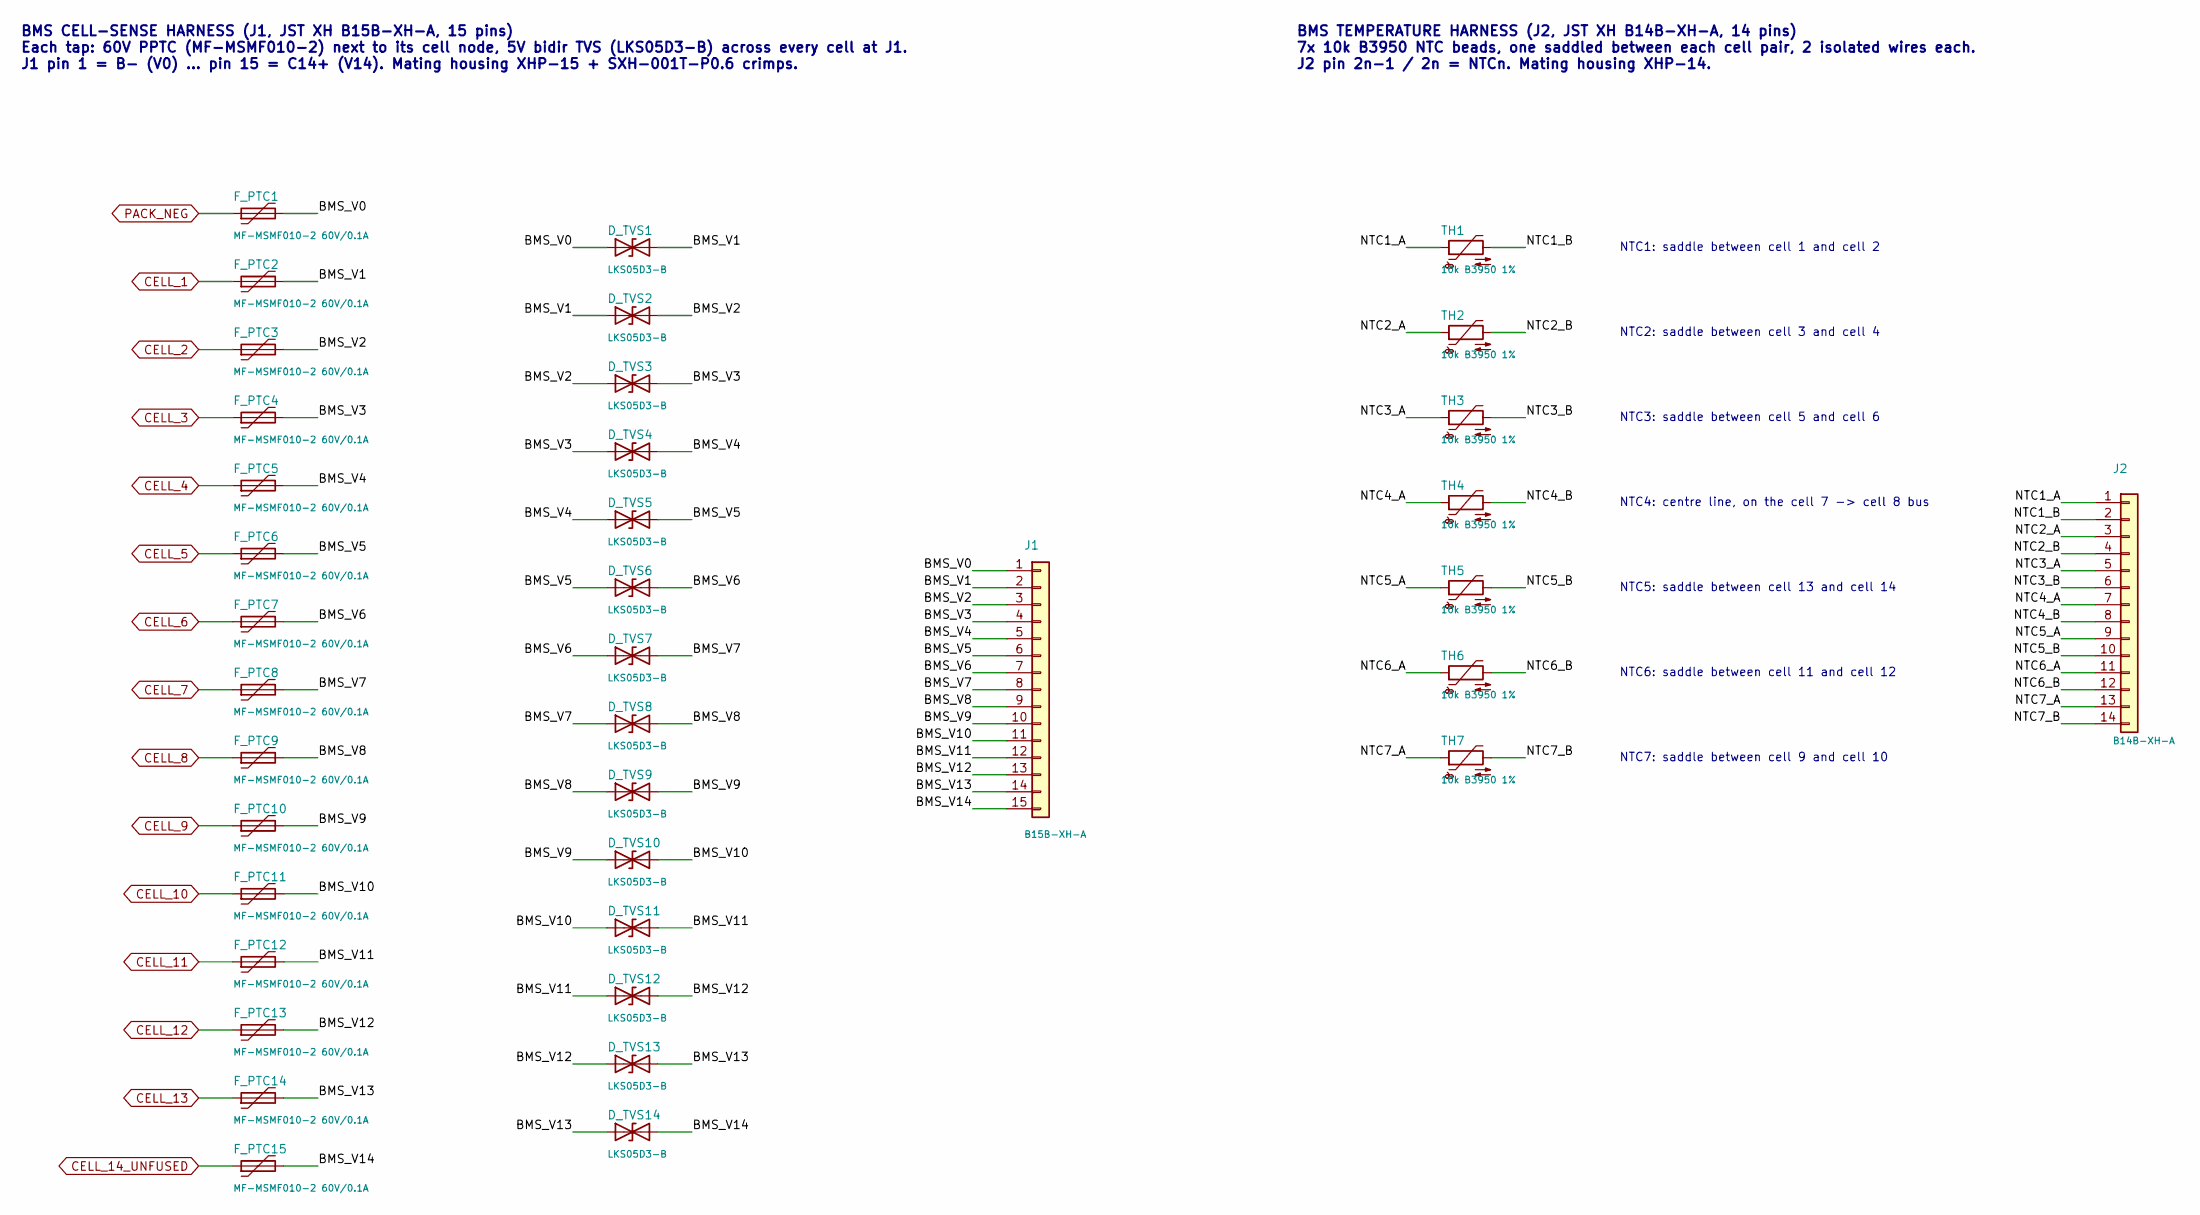
[picture p25: schematic 03_BMS_Interface_and_Thermal.kicad_sch, BMS INTERFACE: 15-WIRE CELL SENSE + 7x NTC]

Parts:
D_TVS1, D_TVS2, D_TVS3, D_TVS4, D_TVS5, D_TVS6, D_TVS7, D_TVS8, D_TVS9, D_TVS10, D_TVS11, D_TVS12, D_TVS13, D_TVS14: LKS05D3-B; D_SOD-323; MPN LKS05D3-B; LCSC C2984829
F_PTC1, F_PTC2, F_PTC3, F_PTC4, F_PTC5, F_PTC6, F_PTC7, F_PTC8, F_PTC9, F_PTC10, F_PTC11, F_PTC12, F_PTC13, F_PTC14, F_PTC15: MF-MSMF010-2 60V/0.1A; Fuse_1812_4532Metric; MPN MF-MSMF010-2; LCSC C12430
J1: B15B-XH-A; JST_XH_B15B-XH-A_1x15_P2.50mm_Vertical; MPN B15B-XH-A(LF)(SN); LCSC C158020
J2: B14B-XH-A; JST_XH_B14B-XH-A_1x14_P2.50mm_Vertical; MPN B14B-XH-A(LF)(SN); LCSC C158022
TH1, TH2, TH3, TH4, TH5, TH6, TH7: 10k B3950 1%; R_Axial_DIN0204_L3.6mm_D1.6mm_P2.54mm_Vertical; MPN MF52A103F3950; LCSC C13879

Connections:
/03_BMS_Interface_and_Thermal/BMS_V0: D_TVS1.1 (A1), F_PTC1.2, J1.1
/03_BMS_Interface_and_Thermal/BMS_V1: D_TVS1.2 (A2), D_TVS2.1 (A1), F_PTC2.2, J1.2
/03_BMS_Interface_and_Thermal/BMS_V2: D_TVS2.2 (A2), D_TVS3.1 (A1), F_PTC3.2, J1.3
/03_BMS_Interface_and_Thermal/BMS_V3: D_TVS3.2 (A2), D_TVS4.1 (A1), F_PTC4.2, J1.4
/03_BMS_Interface_and_Thermal/BMS_V4: D_TVS4.2 (A2), D_TVS5.1 (A1), F_PTC5.2, J1.5
/03_BMS_Interface_and_Thermal/BMS_V5: D_TVS5.2 (A2), D_TVS6.1 (A1), F_PTC6.2, J1.6
/03_BMS_Interface_and_Thermal/BMS_V6: D_TVS6.2 (A2), D_TVS7.1 (A1), F_PTC7.2, J1.7
/03_BMS_Interface_and_Thermal/BMS_V7: D_TVS7.2 (A2), D_TVS8.1 (A1), F_PTC8.2, J1.8
/03_BMS_Interface_and_Thermal/BMS_V8: D_TVS8.2 (A2), D_TVS9.1 (A1), F_PTC9.2, J1.9
/03_BMS_Interface_and_Thermal/BMS_V9: D_TVS9.2 (A2), D_TVS10.1 (A1), F_PTC10.2, J1.10
/03_BMS_Interface_and_Thermal/BMS_V10: D_TVS10.2 (A2), D_TVS11.1 (A1), F_PTC11.2, J1.11
/03_BMS_Interface_and_Thermal/BMS_V11: D_TVS11.2 (A2), D_TVS12.1 (A1), F_PTC12.2, J1.12
/03_BMS_Interface_and_Thermal/BMS_V12: D_TVS12.2 (A2), D_TVS13.1 (A1), F_PTC13.2, J1.13
/03_BMS_Interface_and_Thermal/BMS_V13: D_TVS13.2 (A2), D_TVS14.1 (A1), F_PTC14.2, J1.14
/03_BMS_Interface_and_Thermal/BMS_V14: D_TVS14.2 (A2), F_PTC15.2, J1.15
/03_BMS_Interface_and_Thermal/NTC1_A: J2.1, TH1.1
/03_BMS_Interface_and_Thermal/NTC1_B: J2.2, TH1.2
/03_BMS_Interface_and_Thermal/NTC2_A: J2.3, TH2.1
/03_BMS_Interface_and_Thermal/NTC2_B: J2.4, TH2.2
/03_BMS_Interface_and_Thermal/NTC3_A: J2.5, TH3.1
/03_BMS_Interface_and_Thermal/NTC3_B: J2.6, TH3.2
/03_BMS_Interface_and_Thermal/NTC4_A: J2.7, TH4.1
/03_BMS_Interface_and_Thermal/NTC4_B: J2.8, TH4.2
/03_BMS_Interface_and_Thermal/NTC5_A: J2.9, TH5.1
/03_BMS_Interface_and_Thermal/NTC5_B: J2.10, TH5.2
/03_BMS_Interface_and_Thermal/NTC6_A: J2.11, TH6.1
/03_BMS_Interface_and_Thermal/NTC6_B: J2.12, TH6.2
/03_BMS_Interface_and_Thermal/NTC7_A: J2.13, TH7.1
/03_BMS_Interface_and_Thermal/NTC7_B: J2.14, TH7.2
CELL_1: F_PTC2.1; also elsewhere on the board
CELL_2: F_PTC3.1; also elsewhere on the board
CELL_3: F_PTC4.1; also elsewhere on the board
CELL_4: F_PTC5.1; also elsewhere on the board
CELL_5: F_PTC6.1; also elsewhere on the board
CELL_6: F_PTC7.1; also elsewhere on the board
CELL_7: F_PTC8.1; also elsewhere on the board
CELL_8: F_PTC9.1; also elsewhere on the board
CELL_9: F_PTC10.1; also elsewhere on the board
CELL_10: F_PTC11.1; also elsewhere on the board
CELL_11: F_PTC12.1; also elsewhere on the board
CELL_12: F_PTC13.1; also elsewhere on the board
CELL_13: F_PTC14.1; also elsewhere on the board
CELL_14_UNFUSED: F_PTC15.1; also elsewhere on the board
PACK_NEG: F_PTC1.1; also elsewhere on the board

Notes on the sheet:
BMS TEMPERATURE HARNESS (J2, JST XH B14B-XH-A, 14 pins) 7x 10k B3950 NTC beads, one saddled between each cell pair, 2 isolated wires each. J2 pin 2n-1 / 2n = NTCn. Mating housing XHP-14.
NTC6: saddle between cell 11 and cell 12
NTC2: saddle between cell 3 and cell 4
NTC3: saddle between cell 5 and cell 6
NTC5: saddle between cell 13 and cell 14
NTC4: centre line, on the cell 7 -> cell 8 bus
BMS CELL-SENSE HARNESS (J1, JST XH B15B-XH-A, 15 pins) Each tap: 60V PPTC (MF-MSMF010-2) next to its cell node, 5V bidir TVS (LKS05D3-B) across every cell at J1. J1 pin 1 = B- (V0) ... pin 15 = C14+ (V14). Mating housing XHP-15 + SXH-001T-P0.6 crimps.
NTC1: saddle between cell 1 and cell 2
NTC7: saddle between cell 9 and cell 10

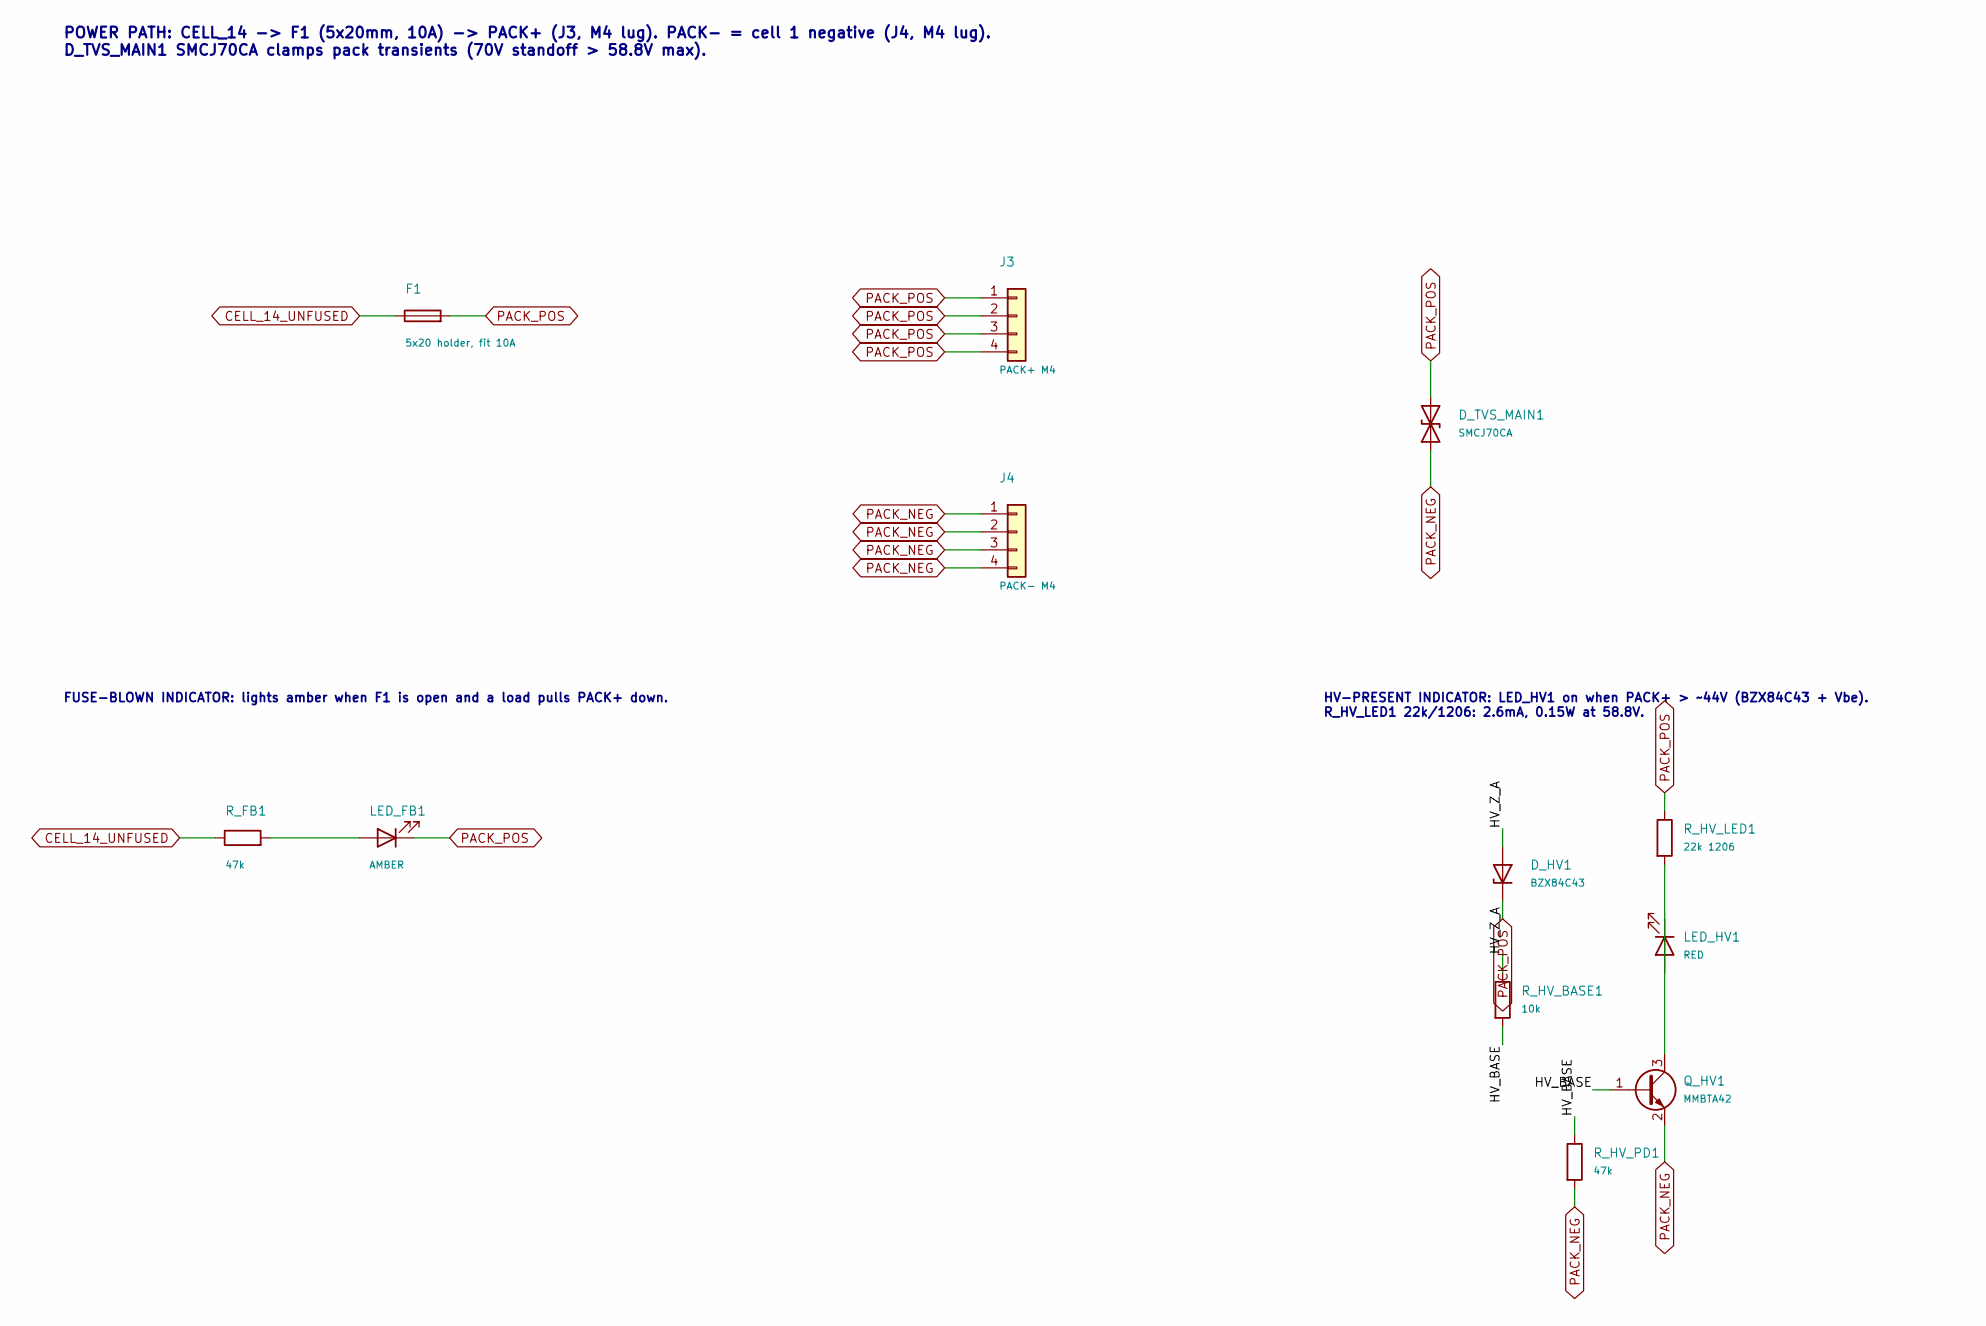
[picture p26: schematic 04_Power_Path_and_Protection.kicad_sch, POWER PATH: FUSE, PACK TERMINALS, TVS, INDICATORS]

Parts:
D_HV1: BZX84C43; SOT-23; MPN BZX84C43; LCSC C841170
D_TVS_MAIN1: SMCJ70CA; D_SMC; MPN SMCJ70CA; LCSC C840779
F1: 5x20 holder, fit 10A; FUSE-TH_L24.8-W9.8-P22.60; MPN FH1-200CK-B; LCSC C268205
J3: PACK+ M4; CONN-TH_4P-L11.1-W9.2-P5.00-T44009; MPN T44009; LCSC C481463
J4: PACK- M4; CONN-TH_4P-L11.1-W9.2-P5.00-T44009; MPN T44009; LCSC C481463
LED_FB1: AMBER; LED_0805_2012Metric; MPN KT-0805Y; LCSC C2296
LED_HV1: RED; LED_0805_2012Metric; MPN NCD0805R1; LCSC C84256
Q_HV1: MMBTA42; SOT-23; MPN MMBTA42; LCSC C8515
R_FB1: 47k; R_0805_2012Metric; MPN 0805W8F4702T5E; LCSC C17713
R_HV_BASE1: 10k; R_0805_2012Metric; MPN 0805W8F1002T5E; LCSC C17414
R_HV_LED1: 22k 1206; R_1206_3216Metric; MPN 1206W4F2202T5E; LCSC C25830
R_HV_PD1: 47k; R_0805_2012Metric; MPN 0805W8F4702T5E; LCSC C17713

Connections:
/04_Power_Path_and_Protection/HV_BASE: Q_HV1.1 (B), R_HV_BASE1.2, R_HV_PD1.1
/04_Power_Path_and_Protection/HV_Z_A: D_HV1.1 (A), R_HV_BASE1.1
CELL_14_UNFUSED: F1.1, R_FB1.1; also elsewhere on the board
unnamed: LED_FB1.2 (A), R_FB1.2
PACK_NEG: D_TVS_MAIN1.1 (A1), J4.1, J4.2, J4.3, J4.4, Q_HV1.2 (E), R_HV_PD1.2; also elsewhere on the board
PACK_POS: D_HV1.3 (K), D_TVS_MAIN1.2 (A2), F1.2, J3.1, J3.2, J3.3, J3.4, LED_FB1.1 (K), R_HV_LED1.1

Notes on the sheet:
FUSE-BLOWN INDICATOR: lights amber when F1 is open and a load pulls PACK+ down.
HV-PRESENT INDICATOR: LED_HV1 on when PACK+ > ~44V (BZX84C43 + Vbe). R_HV_LED1 22k/1206: 2.6mA, 0.15W at 58.8V.
POWER PATH: CELL_14 -> F1 (5x20mm, 10A) -> PACK+ (J3, M4 lug). PACK- = cell 1 negative (J4, M4 lug). D_TVS_MAIN1 SMCJ70CA clamps pack transients (70V standoff > 58.8V max).

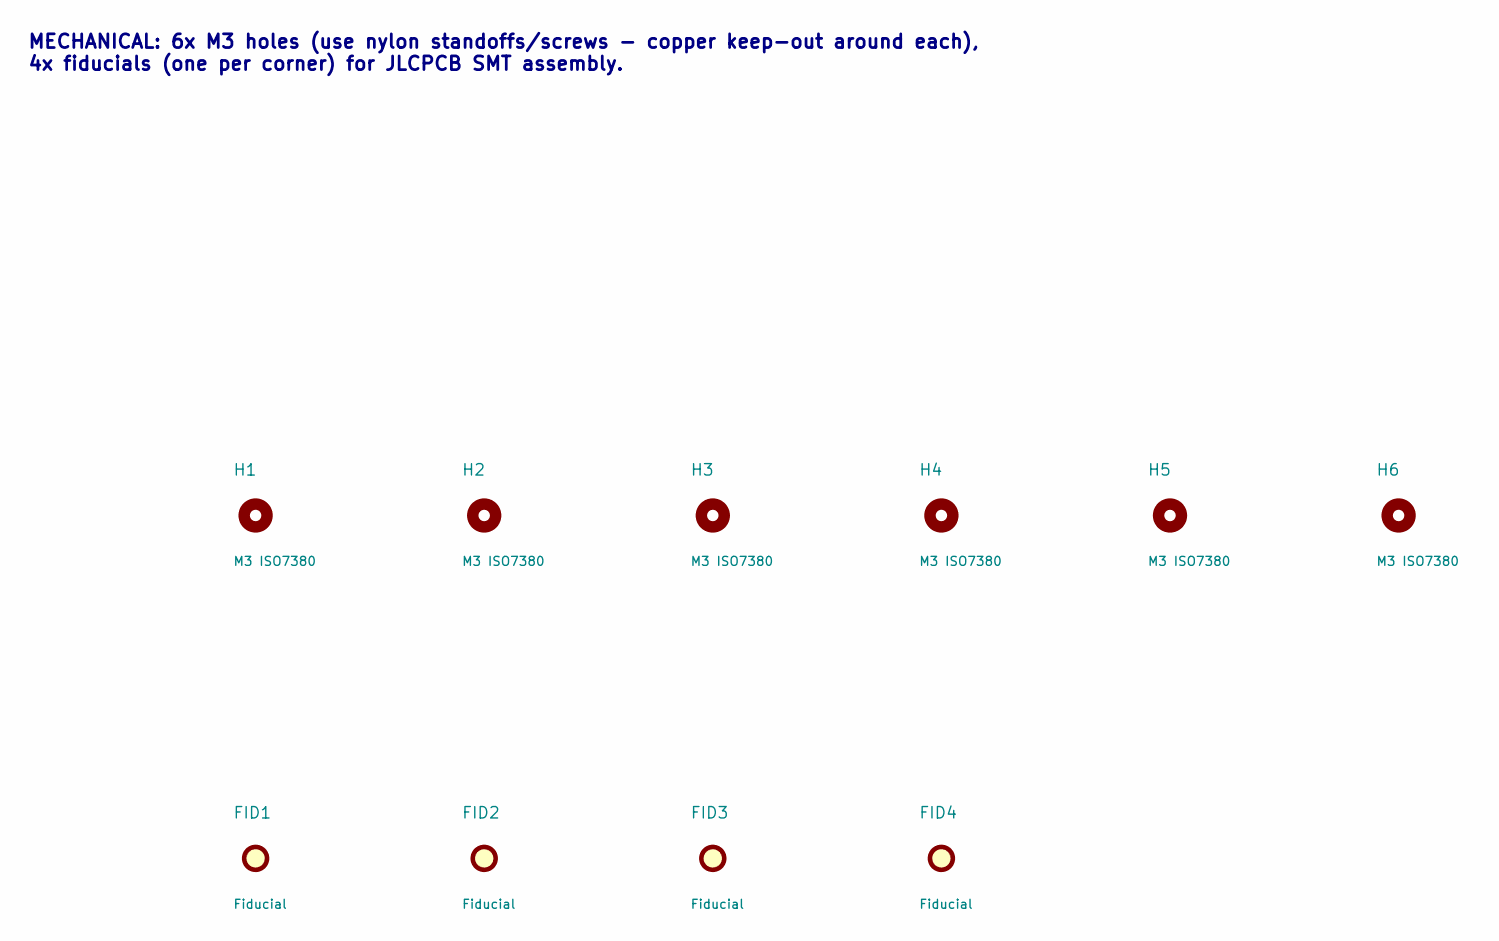
[picture p27: schematic 05_Mechanical_and_Hardware.kicad_sch, MECHANICAL: MOUNTING HOLES & FIDUCIALS]

Parts:
FID1, FID2, FID3, FID4: Fiducial; Fiducial_1mm_Mask2mm
H1, H2, H3, H4, H5, H6: M3 ISO7380; MountingHole_3.2mm_M3_ISO7380

Notes on the sheet:
MECHANICAL: 6x M3 holes (use nylon standoffs/screws - copper keep-out around each), 4x fiducials (one per corner) for JLCPCB SMT assembly.

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
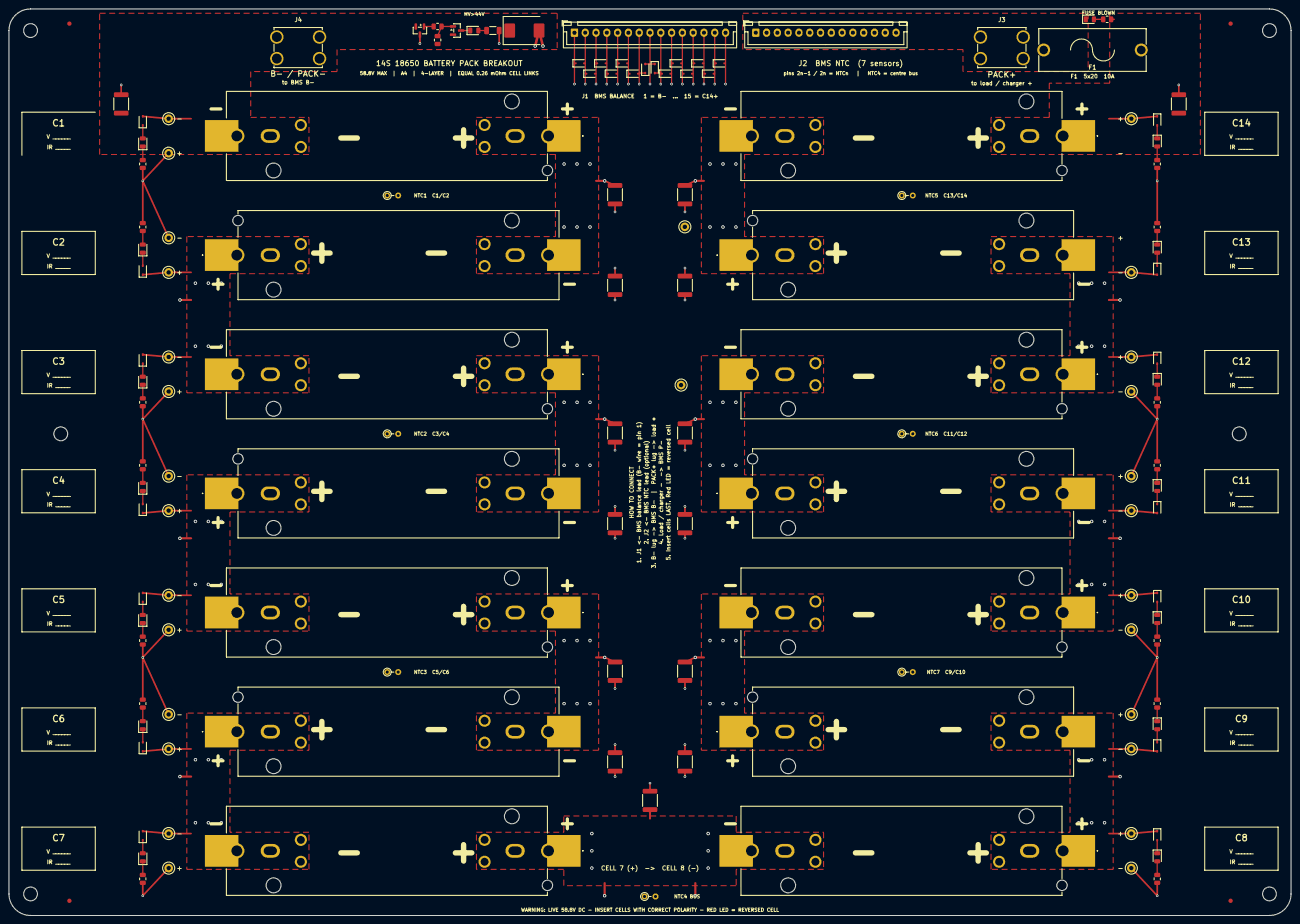
[picture p28: board BatteryPack_16S_A4_Breakout.kicad_pcb from above]

Board: 4 copper layers, 297.0 x 210.0 mm, 144 parts (0 on the bottom side), 78 nets.
