P-Shreyas543/BatteryPack_16S_A4_Breakout/(commit log)

2026-10-12 Convert pack to 14S with 7 NTC sensors, JST XH harness connectors, all-JLC BOM
    - Schematic regenerated: 14 cells, 15-wire BMS sense on JST XH B15B-XH-A,
    7x 10k B3950 NTC saddles on JST XH B14B-XH-A, per-cell test loops and
    reverse-insertion indicator, power path with 5x20 fuse and M4 lugs.
    - Fixes: HV zener was reversed, 4.7k/1206 HV LED resistor dissipated 0.68W
    (now 22k), 24V PPTCs on sense taps replaced with 60V MF-MSMF010-2,
    fuse-blown LED polarity corrected.
    - Banana jacks (not stocked at LCSC) replaced by Keystone 5000/5001 loops.
    - PCB re-laid out on the A4 (297x210) 4-layer outline: 8+6 cell columns,
    zones for cell links, sense routed on In1, NTC pairs on In2.
    - ERC 0, DRC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
2026-10-13 Mirror the two cell columns (7+7) and move every external connector to the top edge
    - Cells 1-7 down the left column, 8-14 up the right, identical row spacing;
    B- now lands at the top-left corner and cell 14+ at the top-right.
    - Top edge, left to right: J2 NTC, B- lug, J1 balance (centred), PACK+ lug,
    5x20 fuse. Balance pin 1 = B- on the left, matching the cell order.
    - PPTC/TVS sense block sits directly under J1; sense taps fan in on In1,
    NTC pairs run up to J2 on In2. NTCs renumbered along the series path.
    - Pack TVS and HV indicator next to PACK+, PACK- return on a B.Cu strip.
    - Mid-board M3 holes moved into the channel; wiring guide on silkscreen.
    - ERC 0, DRC 0 (all severities), 0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
2026-10-13 Senior-level layout rework: equal-resistance cell links, uniform pitch, sense spine
    - Uniform 27.6 mm cell pitch (4.8 mm air gap around every cell).
    - All 13 cell-to-cell links are identical copper straps (F.Cu + B.Cu); the
    cell 7->8 strap across the channel is widened to 16.15 mm so its
    resistance matches. 2-D field solve: 0.260 mOhm per link, 0.08 % spread
    (tools/acir.py, docs/acir_check.txt).
    - Centre channel is now a sense spine: a 60 V PPTC at every node and one
    In1 bus into J1; per-cell TVS moved to SOD-323 (LKS05D3-B) directly under
    J1 so the whole BMS protection block sits on the top edge.
    - Outer margins: per-cell test loops, reverse-cell LED, writable V/IR box.
    - Top edge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
2026-10-13 Make the board mirror-symmetric about its centre line
    - NTCs: 3 per side in mirrored gaps, NTC4 on the centre line at the
    cell 7->8 bus (J2 pins 7/8); J2 pin 2n-1/2n = NTCn kept.
    - Sense spine exactly symmetric: tap-7 PPTC and its bus line on the centre
    line, side buses mirrored, J1 fan symmetric.
    - Per-cell LED strings: series order chosen per cell so mirrored twins use
    the same parts in the same places (function unchanged).
    - TVS chain under J1 mirrored; the centre pair stands vertically either side
    of lane 7.
    - HV indicator + pack TVS centred at J2's mirror position; top-band copper
    mirrored; 4 corner fiducials.
    - tools/symcheck.py audits mirror partners: only J2, the HV block a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
2026-10-26 Remove KiCad auto-backups and ignore *-backups/
    The backups folder held KiCad's automatic project-backup zips and an old
    extracted schematic; they bloat the repo and are regenerated on every save.
